pswiss/Swissler-2020-FireAnt3D-Design/CAD/Shell/Flower_Lainflat.SLDASM

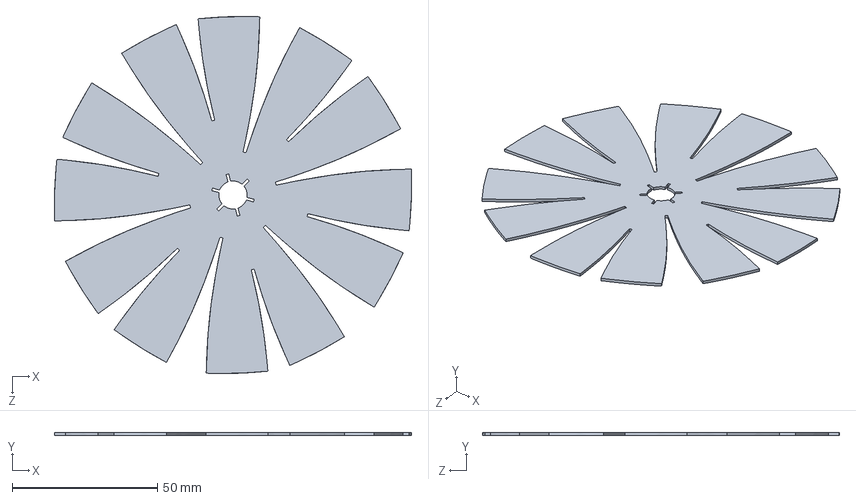
[picture p1: CAD file, 2020-07-23]
CAD/Shell/Flower_Lainflat.SLDASM
122.9 x 1.00 x 122.8 mm
