pswiss/Swissler-2020-FireAnt3D-Design/CAD/BatteryHalf_Assy.SLDASM

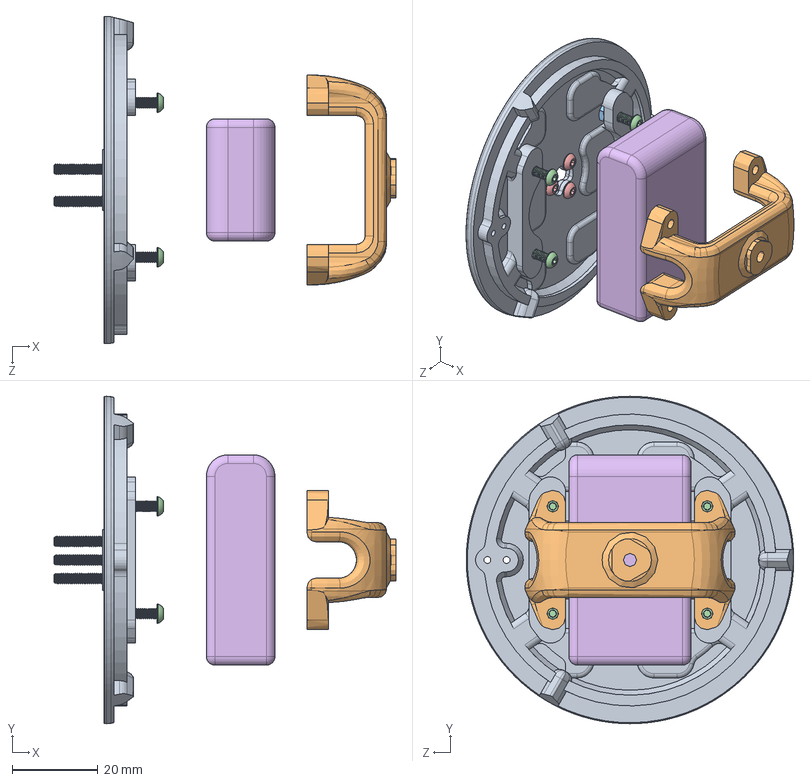
[picture p2: CAD file, 2020-07-23]
CAD/BatteryHalf_Assy.SLDASM
79.7 x 76.3 x 76.3 mm
BatteryHalf
Battery_Dock_Mount
90710A025_TYPE 18-8 SS THIN HEX NUT - DIN 439B x 4
92095A460_18-8 SS BUTTON-HEAD SOCKET CAP SCREW x 4
91239A760_CLASS 10.9 STL BUTTON-HEAD SOCKET CAP SCREW x 3
Turnigy nano-tech 450mAh 3S 65C Lipo (E-flite Compatible Blade 180CFX EFLB4503SJ30)
