pswiss/Swissler-2020-FireAnt3D-Design/CAD/Gear_Subassy.SLDASM

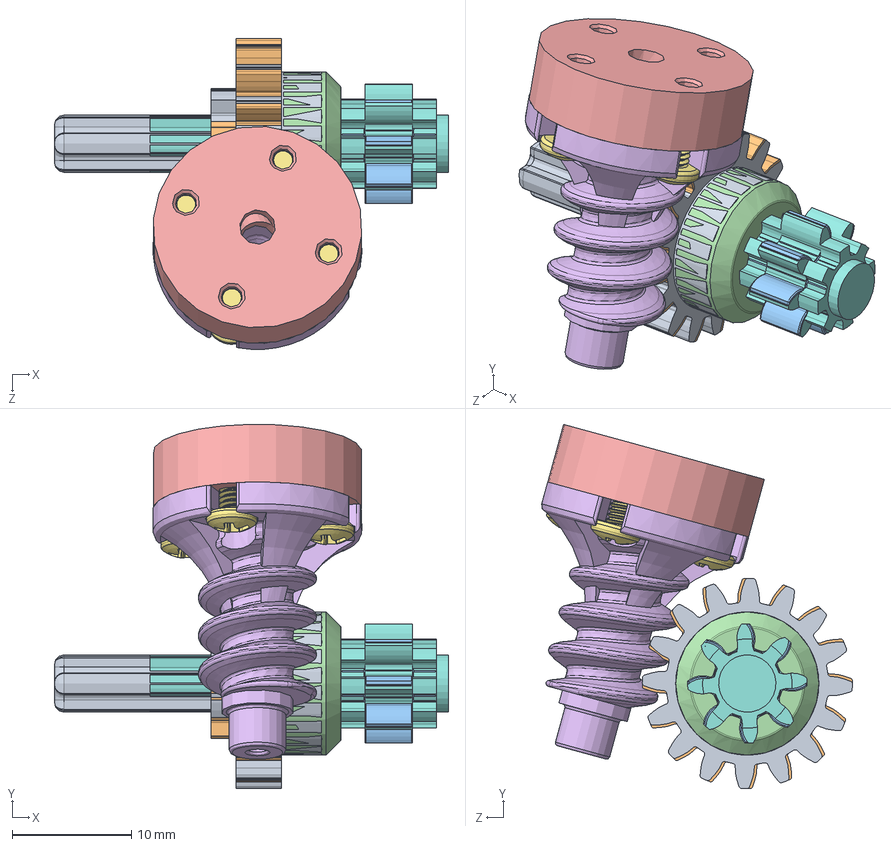
[picture p3: CAD file, 2020-07-23]
CAD/Gear_Subassy.SLDASM
33.0 x 30.5 x 26.0 mm
motorCoupling_2-56
WormGear_3
91735A010_TYPE 316 SS PAN HEAD PHILLIPS MACHINE SCREW x 4
New_8_tooth
ArmDrive_16_Replace
