pswiss/Swissler-2020-FireAnt3D-Design/CAD/Ground_Hoop_SubAssy.SLDASM

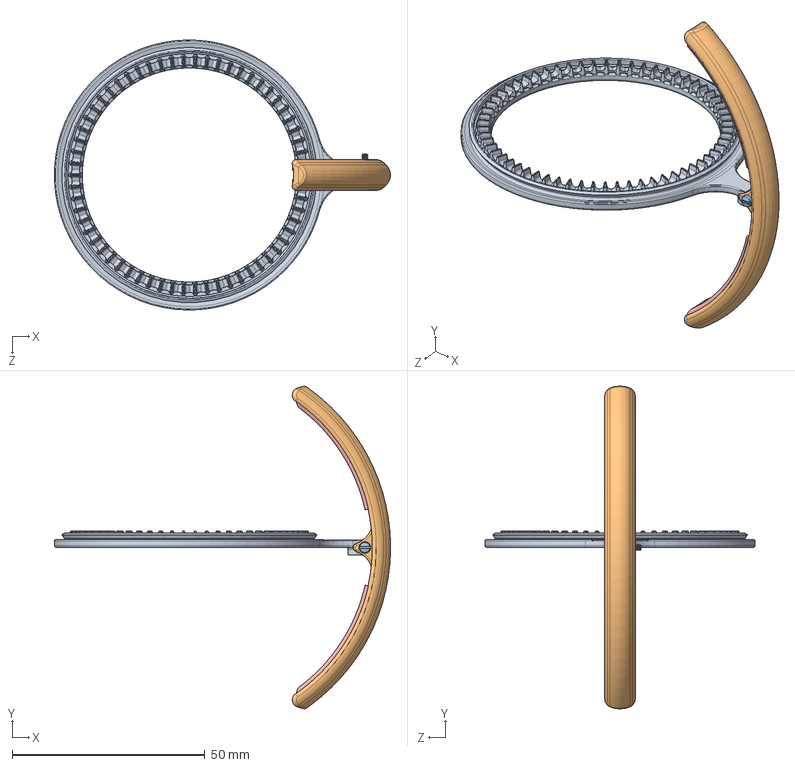
[picture p4: CAD file, 2020-07-23]
CAD/Ground_Hoop_SubAssy.SLDASM
87.1 x 83.6 x 70.0 mm
GroundHoop-2
Hoop_Formed
91800A008_METRIC CHEESE HEAD SLOTTED MACHINE SCREW
90591A109_ZINC PLATED STEEL HEX NUT
NonconductiveSlide x 2
