pswiss/Swissler-2020-FireAnt3D-Design/CAD/CoupledLegoWormGear.SLDASM

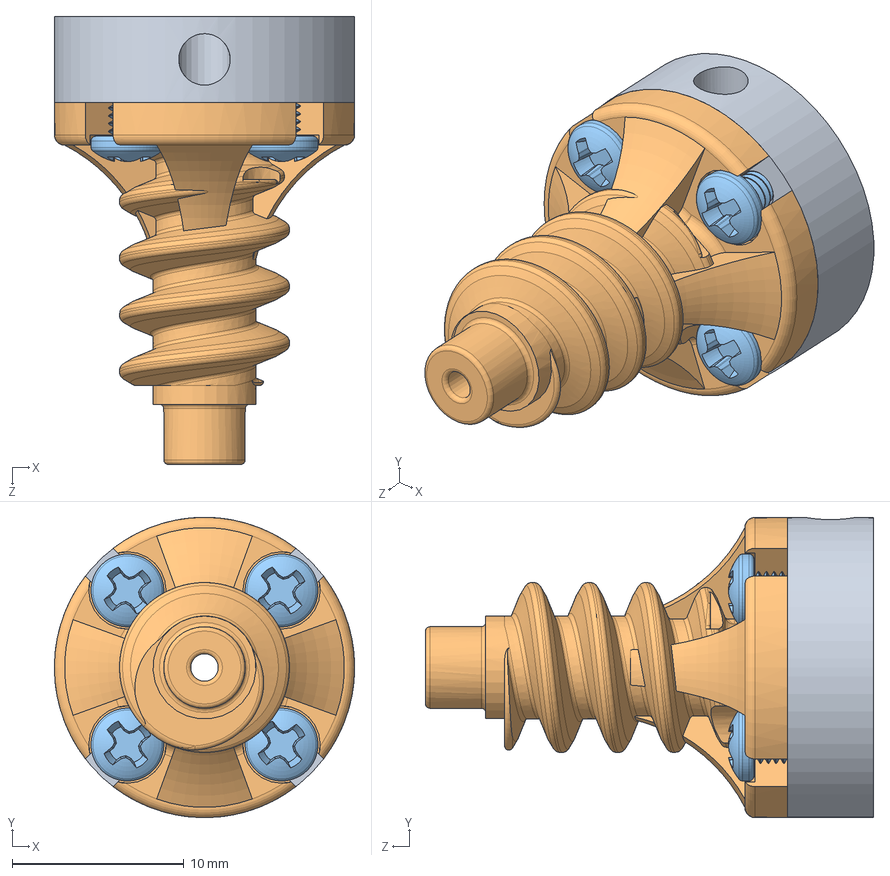
[picture p5: CAD file, 2020-07-23]
CAD/CoupledLegoWormGear.SLDASM
17.5 x 17.5 x 26.1 mm
motorCoupling_2-56
WormGear_3
91735A010_TYPE 316 SS PAN HEAD PHILLIPS MACHINE SCREW x 4
