pswiss/Swissler-2020-FireAnt3D-Design/CAD/HoopGear_SubAssy.SLDASM

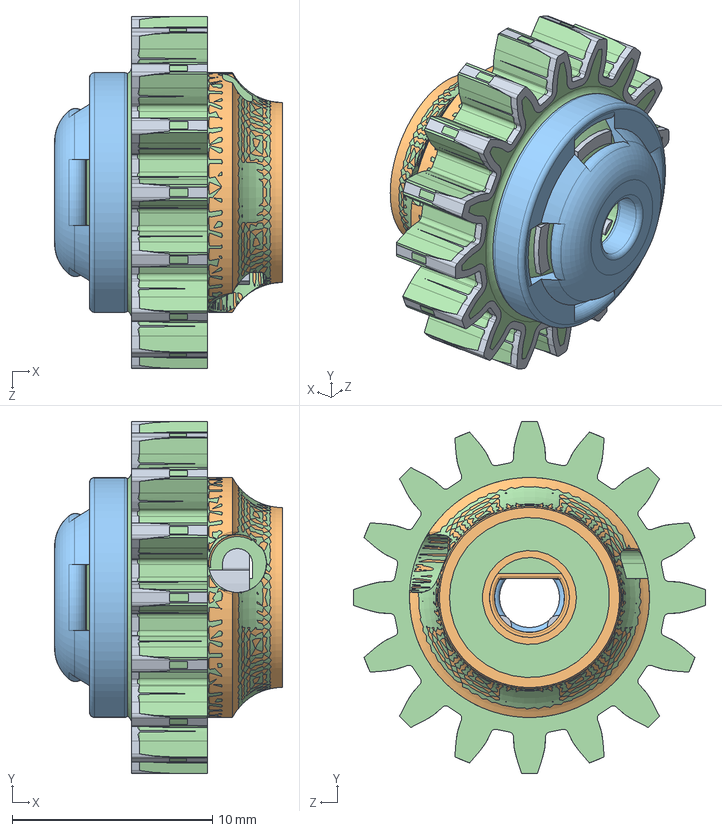
[picture p6: CAD file, 2020-07-23]
CAD/HoopGear_SubAssy.SLDASM
11.4 x 17.6 x 17.6 mm
new16Tooth
HoopGear_MotHalf
customHoopGear
