pswiss/Swissler-2020-FireAnt3D-Design/CAD/Arm_SubAssy.SLDASM

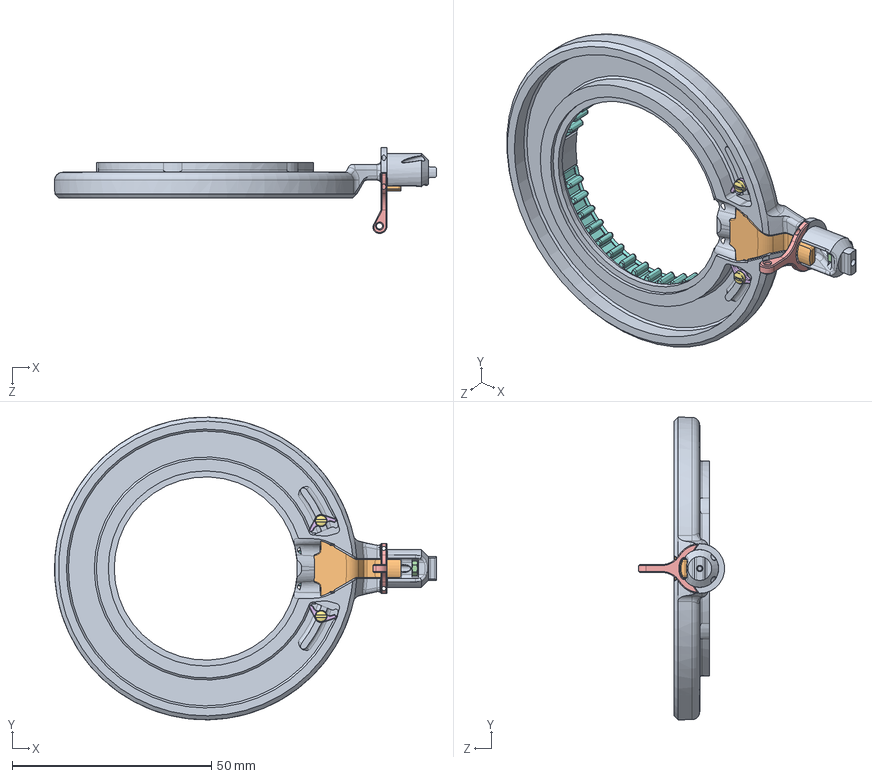
[picture p7: CAD file, 2020-07-23]
CAD/Arm_SubAssy.SLDASM
95.9 x 76.0 x 21.6 mm
SwingArm_Robot_arm_Strengthened
Arm_Top_Cover
91800A008_METRIC CHEESE HEAD SLOTTED MACHINE SCREW x 2
90591A109_ZINC PLATED STEEL HEX NUT
SwingArm_Robot_Returnhold
arm_limit_contact x 2
91800A004_METRIC CHEESE HEAD SLOTTED MACHINE SCREW x 2
SwingArm_Robot_gears
