pswiss/Swissler-2020-FireAnt3D-Design/CAD/ArmDrive_16_Replace.SLDPRT

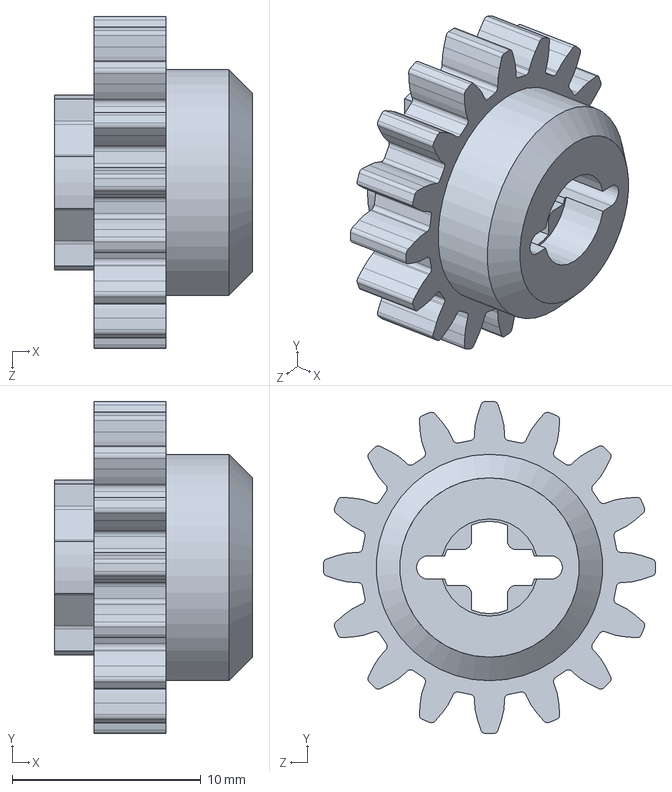
[picture p8: CAD file, 2020-07-23]
CAD/ArmDrive_16_Replace.SLDPRT
10.5 x 17.6 x 17.6 mm
