pswiss/Swissler-2020-FireAnt3D-Design/CAD/Shell/Flower_Lainflat_1.4mm.STL

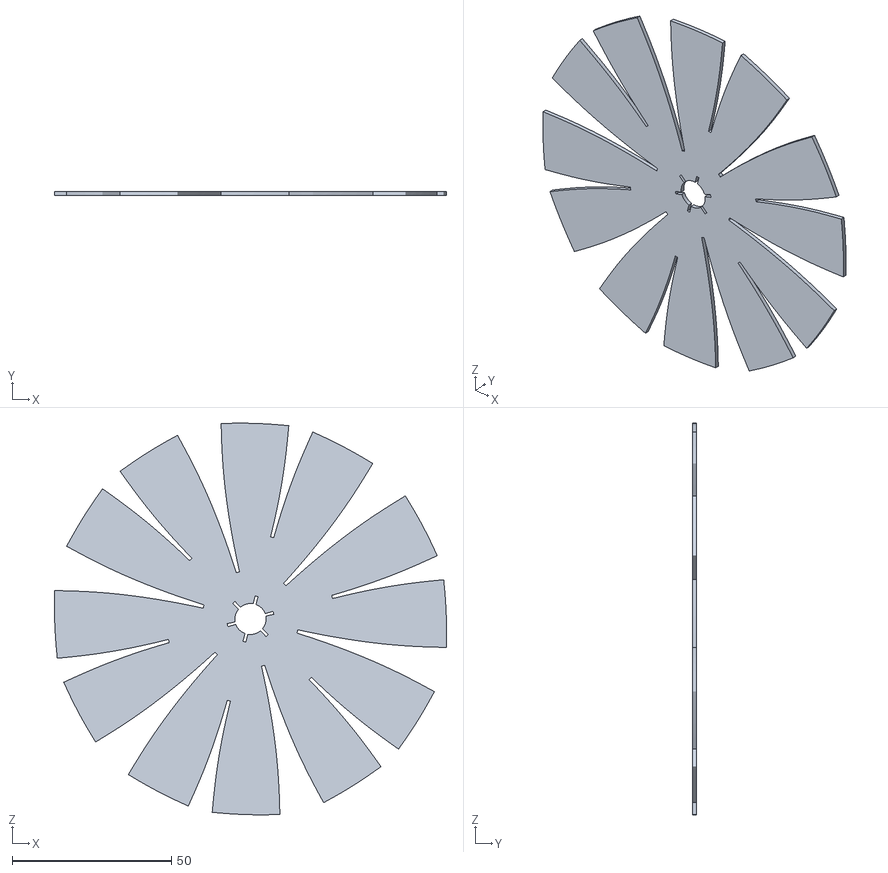
[picture p9: CAD file, 2020-07-23]
CAD/Shell/Flower_Lainflat_1.4mm.STL
122.9 x 1.40 x 122.8
