pswiss/Swissler-2020-FireAnt3D-Design/CAD/ForceSensorShield.SLDPRT

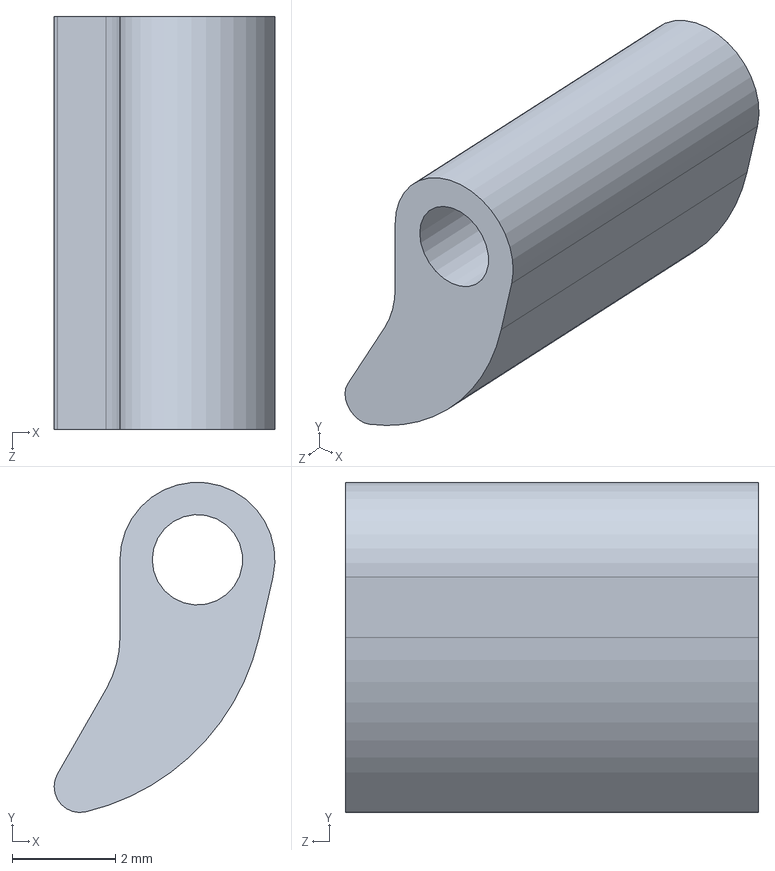
[picture p10: CAD file, 2020-07-23]
CAD/ForceSensorShield.SLDPRT
4.27 x 6.39 x 8.00 mm
