pswiss/Swissler-2020-FireAnt3D-Design/CAD/Arm_Attach.SLDPRT

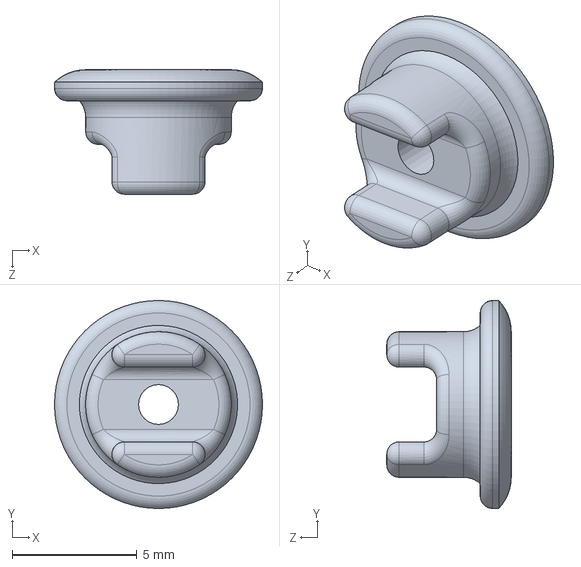
[picture p11: CAD file, 2020-07-23]
CAD/Arm_Attach.SLDPRT
8.35 x 8.35 x 5.00 mm
