pswiss/Swissler-2020-FireAnt3D-Design/CAD/Shell/Flower_Lainflat_0.2mm.STL

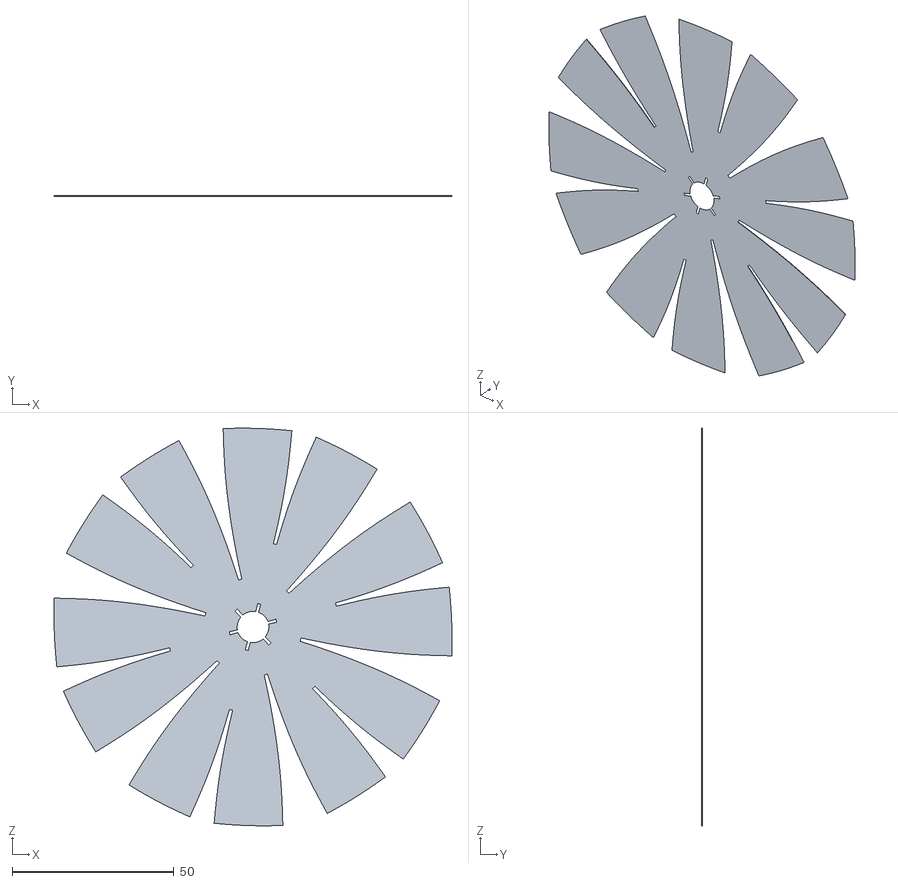
[picture p12: CAD file, 2020-07-23]
CAD/Shell/Flower_Lainflat_0.2mm.STL
122.9 x 0.2 x 122.8
