pswiss/Swissler-2020-FireAnt3D-Design/CAD/NonconductiveSlide.SLDPRT

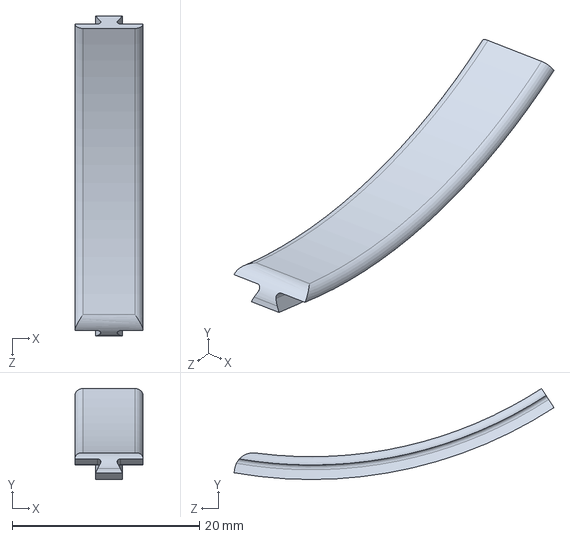
[picture p13: CAD file, 2020-07-23]
CAD/NonconductiveSlide.SLDPRT
7.28 x 9.72 x 34.2 mm
