pswiss/Swissler-2020-FireAnt3D-Design/CAD/Shell/Shell_Flower.SLDPRT

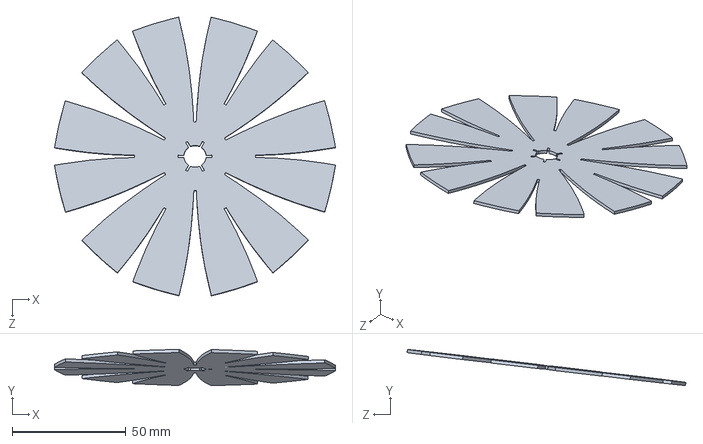
[picture p14: CAD file, 2020-07-23]
CAD/Shell/Shell_Flower.SLDPRT
123.4 x 15.9 x 122.5 mm
