pswiss/Swissler-2020-FireAnt3D-Design/CAD/Wings.SLDPRT

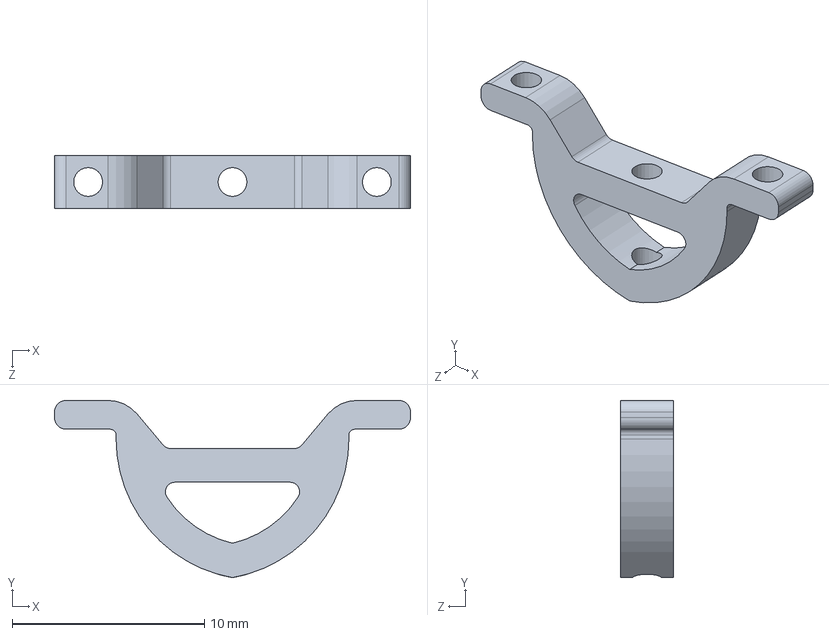
[picture p15: CAD file, 2020-07-23]
CAD/Wings.SLDPRT
18.5 x 9.21 x 2.75 mm
