pswiss/Swissler-2020-FireAnt3D-Design/CAD/HoopGear_HoldHalf.SLDPRT

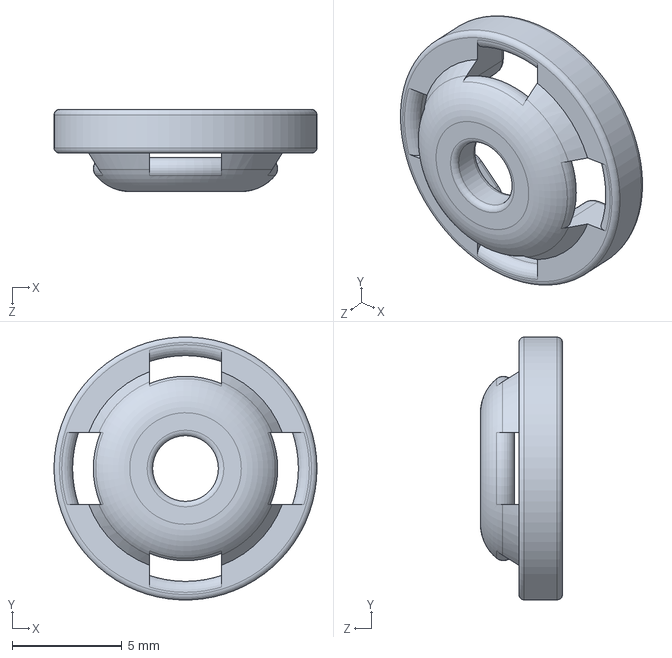
[picture p16: CAD file, 2020-07-23]
CAD/HoopGear_HoldHalf.SLDPRT
12.0 x 12.0 x 3.75 mm
