pswiss/Swissler-2020-FireAnt3D-Design/CAD/SwingArm_Robot_arm_Strengthened.SLDPRT

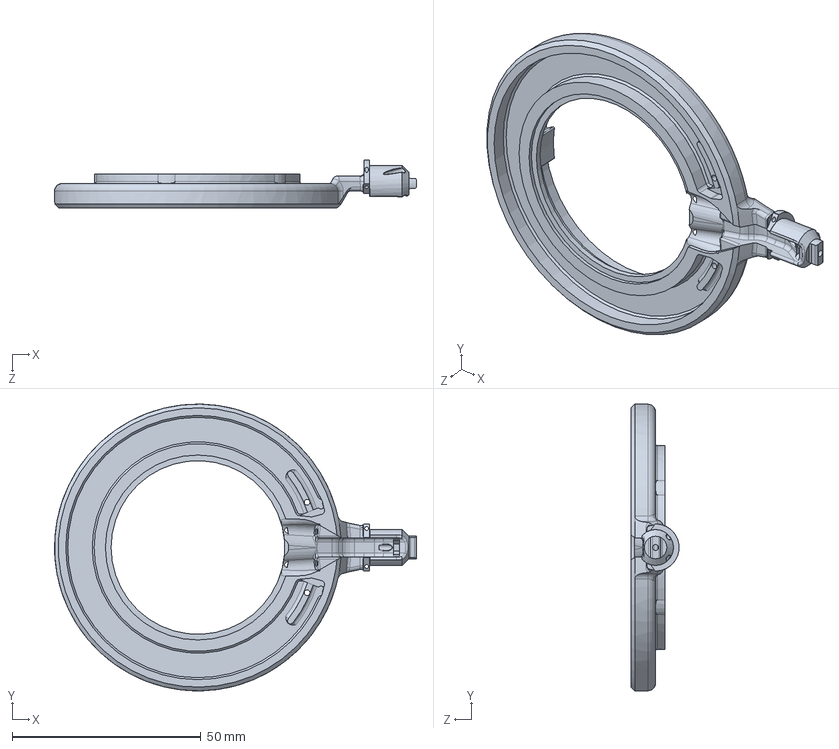
[picture p17: CAD file, 2020-07-23]
CAD/SwingArm_Robot_arm_Strengthened.SLDPRT
95.9 x 76.0 x 12.7 mm
