pswiss/Swissler-2020-FireAnt3D-Design/CAD/Hoop_Spring_Contact.SLDPRT

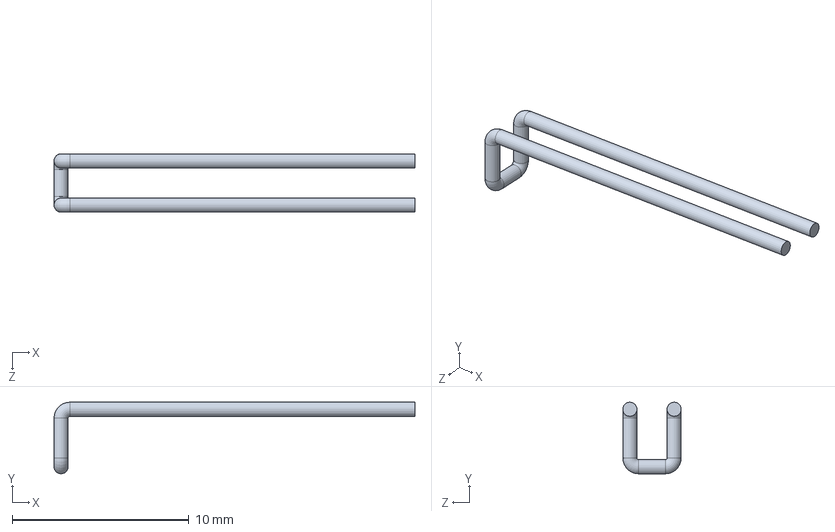
[picture p18: CAD file, 2020-07-23]
CAD/Hoop_Spring_Contact.SLDPRT
20.4 x 4.05 x 3.30 mm
