pswiss/Swissler-2020-FireAnt3D-Design/CAD/New_8_tooth.SLDPRT

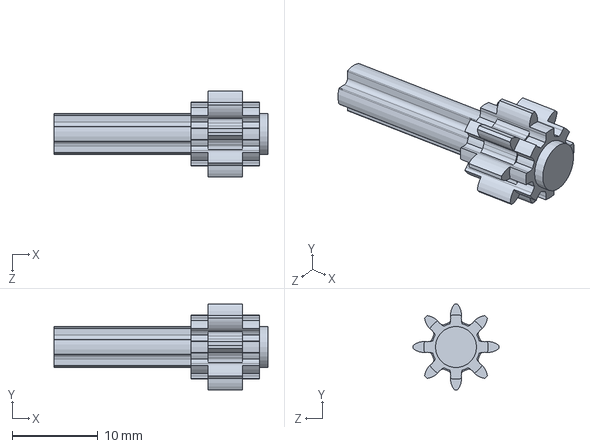
[picture p19: CAD file, 2020-07-23]
CAD/New_8_tooth.SLDPRT
25.0 x 9.99 x 9.99 mm
