pswiss/Swissler-2020-FireAnt3D-Design/CAD/arm_limit_contact.SLDPRT

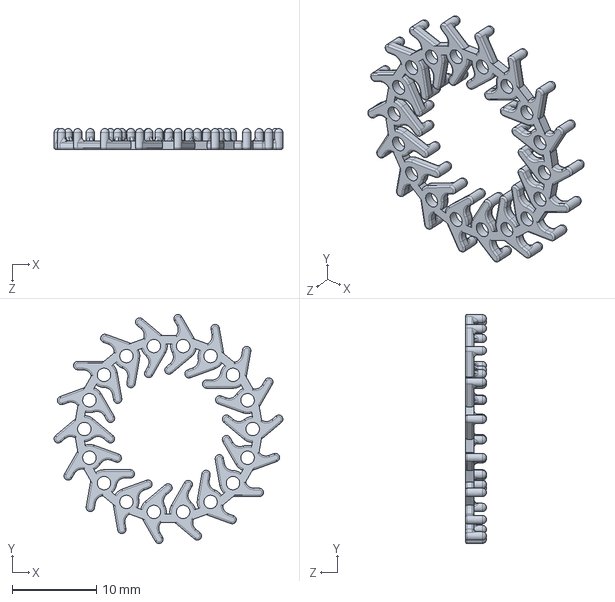
[picture p20: CAD file, 2020-07-23]
CAD/arm_limit_contact.SLDPRT
27.2 x 27.2 x 2.50 mm
