pswiss/Swissler-2020-FireAnt3D-Design/CAD/Gear_Spacer.SLDPRT

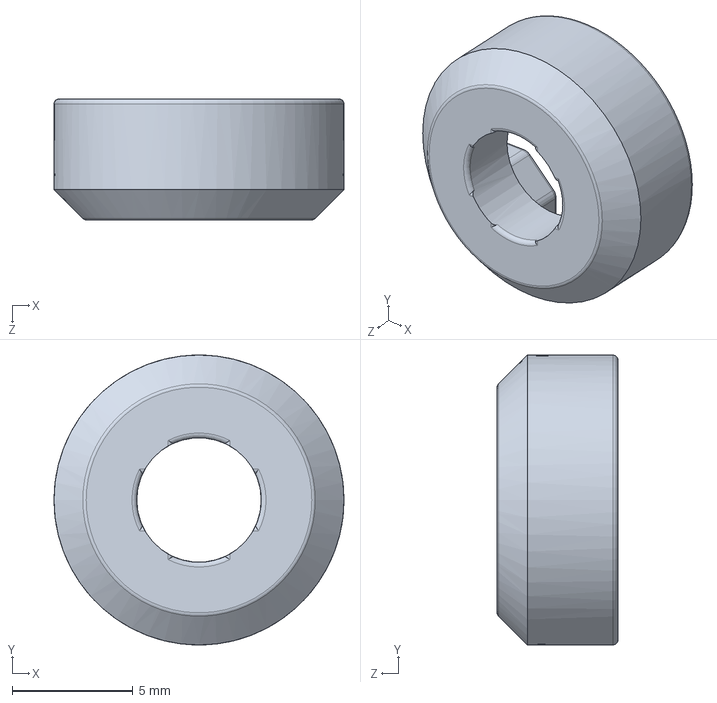
[picture p21: CAD file, 2020-07-23]
CAD/Gear_Spacer.SLDPRT
12.0 x 12.0 x 5.00 mm
