pswiss/Swissler-2020-FireAnt3D-Design/CAD/GroundHoop-2.SLDPRT

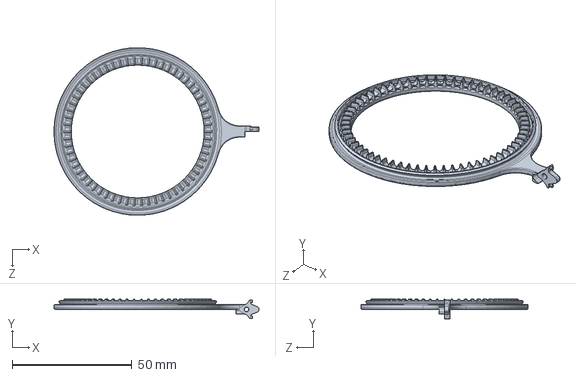
[picture p22: CAD file, 2020-07-23]
CAD/GroundHoop-2.SLDPRT
85.7 x 8.19 x 70.0 mm
