pswiss/Swissler-2020-FireAnt3D-Design/CAD/InnerShield.SLDPRT

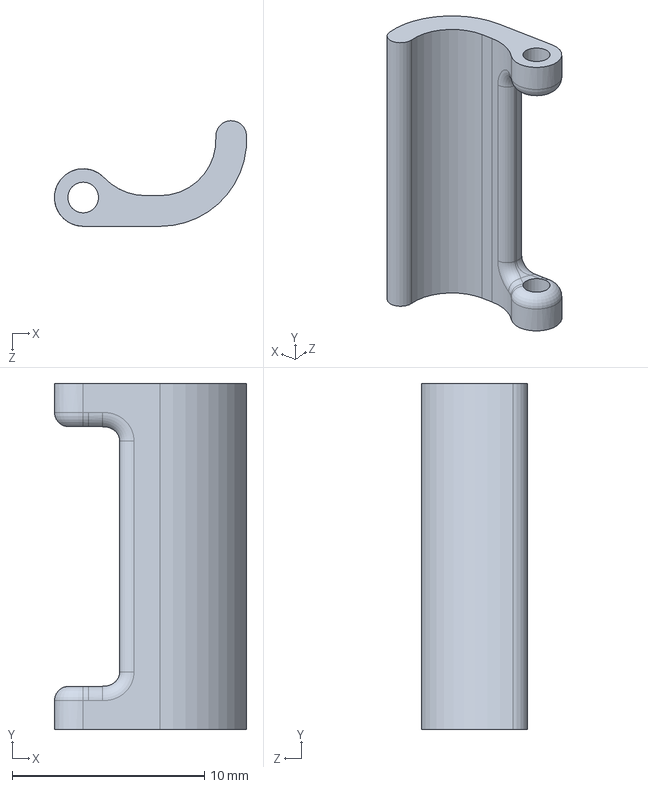
[picture p23: CAD file, 2020-07-23]
CAD/InnerShield.SLDPRT
10.00 x 18.0 x 5.50 mm
