pswiss/Swissler-2020-FireAnt3D-Design/CAD/Clocking_BatteryHalf.SLDPRT

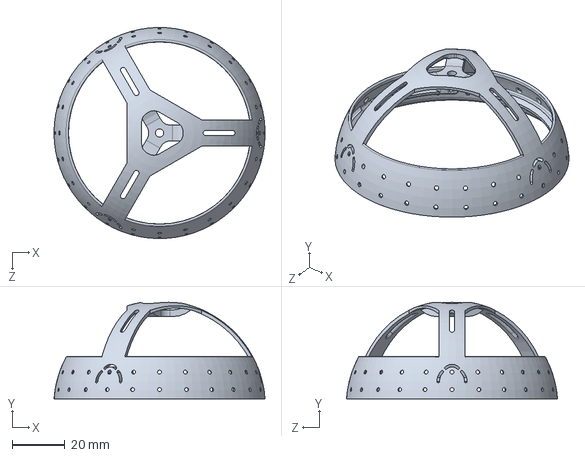
[picture p24: CAD file, 2020-07-23]
CAD/Clocking_BatteryHalf.SLDPRT
79.7 x 36.5 x 79.8 mm
