pswiss/Swissler-2020-FireAnt3D-Design/CAD/SwingArm_Robot_gears.SLDPRT

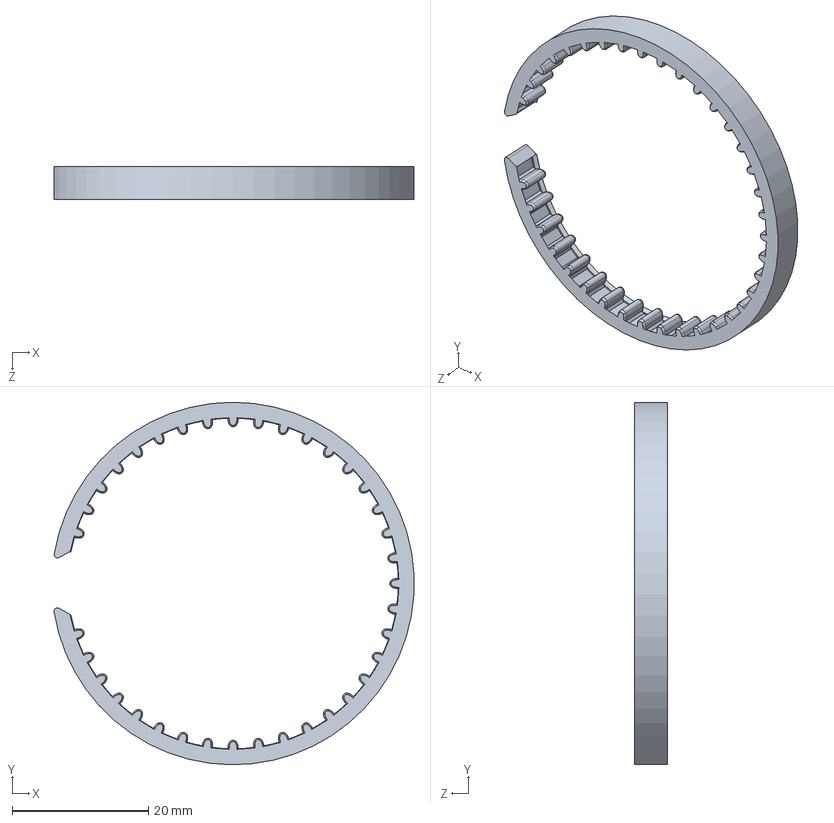
[picture p25: CAD file, 2020-07-23]
CAD/SwingArm_Robot_gears.SLDPRT
52.8 x 53.2 x 4.90 mm
