pswiss/Swissler-2020-FireAnt3D-Design/CAD/Hoop_Formed.SLDPRT

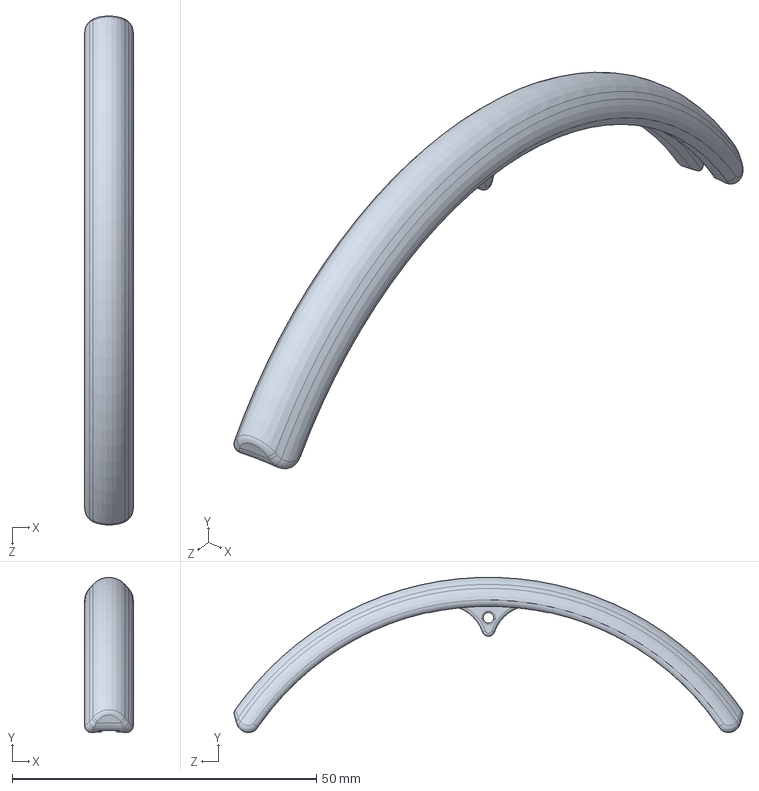
[picture p26: CAD file, 2020-07-23]
CAD/Hoop_Formed.SLDPRT
8.01 x 25.5 x 83.6 mm
