pswiss/Swissler-2020-FireAnt3D-Design/CAD/CenterBody_OuterPart.SLDPRT

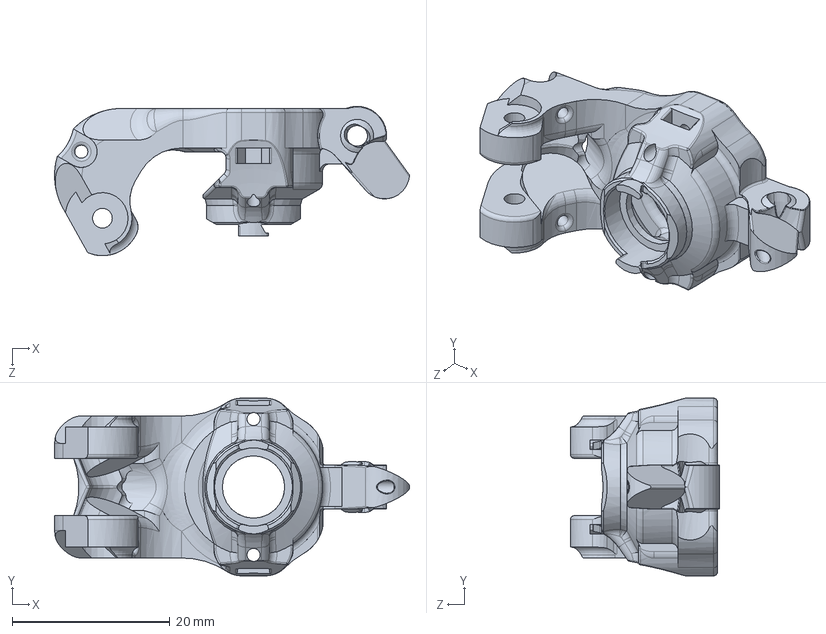
[picture p27: CAD file, 2020-07-23]
CAD/CenterBody_OuterPart.SLDPRT
45.0 x 22.5 x 18.9 mm
