pswiss/Swissler-2020-FireAnt3D-Design/CAD/Battery_Dock_Mount.SLDPRT

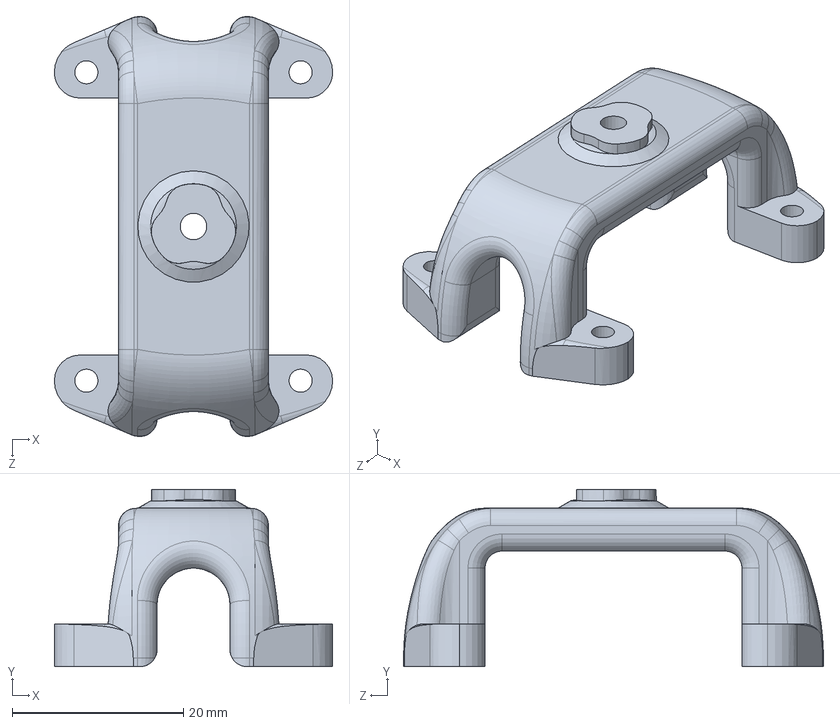
[picture p28: CAD file, 2020-07-23]
CAD/Battery_Dock_Mount.SLDPRT
32.5 x 20.7 x 49.0 mm
