pswiss/Swissler-2020-FireAnt3D-Design/CAD/customHoopGear.SLDPRT

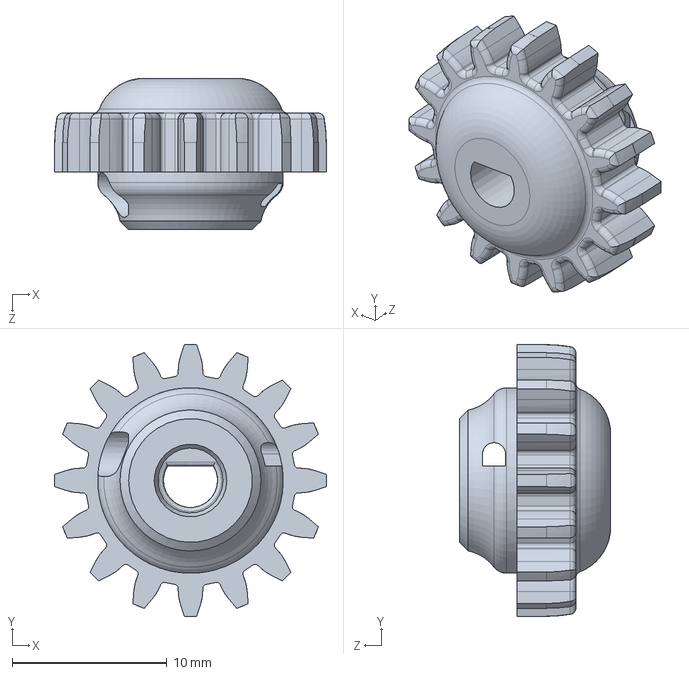
[picture p29: CAD file, 2020-07-23]
CAD/customHoopGear.SLDPRT
17.6 x 17.6 x 9.80 mm
