pswiss/Swissler-2020-FireAnt3D-Design/CAD/NonconductiveSlide_Flex.SLDPRT

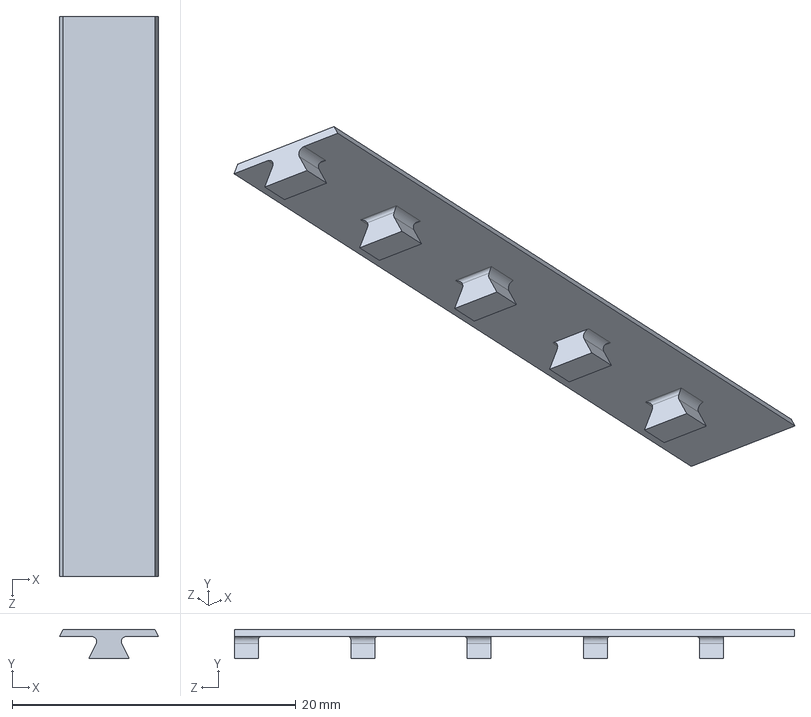
[picture p30: CAD file, 2020-07-23]
CAD/NonconductiveSlide_Flex.SLDPRT
7.00 x 2.05 x 39.5 mm
