pswiss/Swissler-2020-FireAnt3D-Design/CAD/WormGear_3.SLDPRT

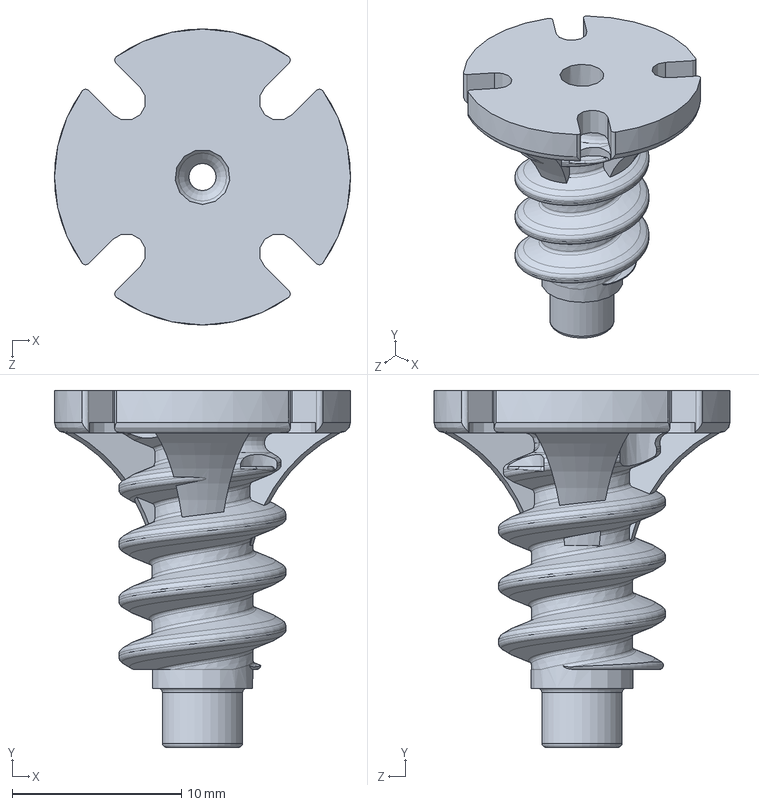
[picture p31: CAD file, 2020-07-23]
CAD/WormGear_3.SLDPRT
17.5 x 21.1 x 17.5 mm
