pswiss/Swissler-2020-FireAnt3D-Design/CAD/Turnigy nano-tech 450mAh 3S 65C Lipo (E-flite Compatible Blade 180CFX EFLB4503SJ30).SLDPRT

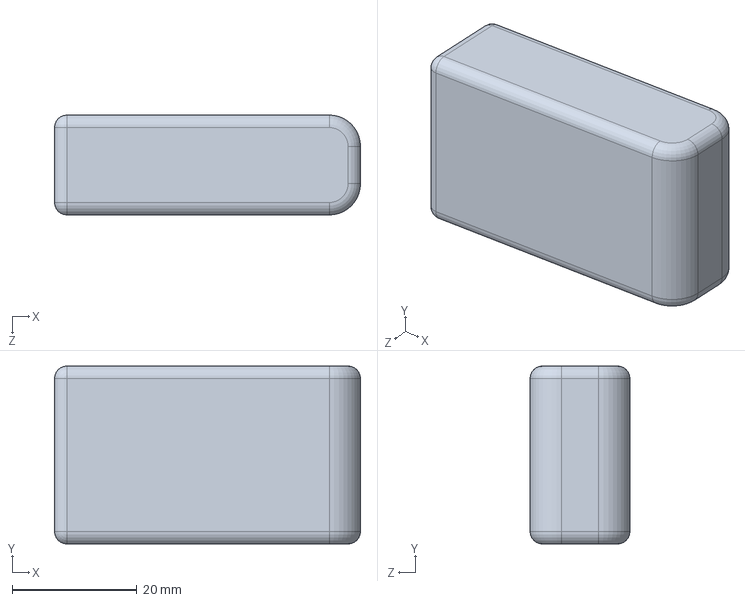
[picture p32: CAD file, 2020-07-23]
CAD/Turnigy nano-tech 450mAh 3S 65C Lipo (E-flite Compatible Blade 180CFX EFLB4503SJ30).SLDPRT
49.0 x 28.5 x 16.0 mm
