pswiss/Swissler-2020-FireAnt3D-Design/CAD/Clocking_MotorHalf.SLDPRT

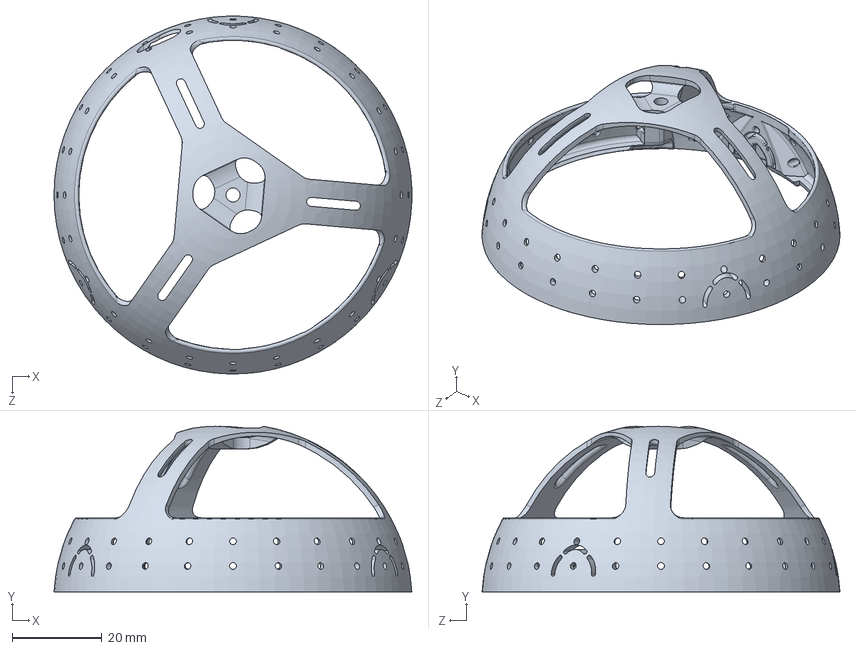
[picture p33: CAD file, 2020-07-23]
CAD/Clocking_MotorHalf.SLDPRT
79.8 x 36.9 x 79.8 mm
