pswiss/Swissler-2020-FireAnt3D-Design/CAD/HoopGear_MotHalf.SLDPRT

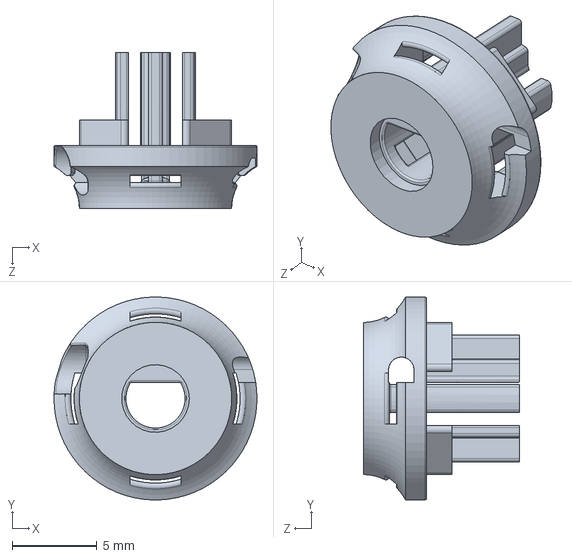
[picture p34: CAD file, 2020-07-23]
CAD/HoopGear_MotHalf.SLDPRT
12.0 x 12.0 x 9.25 mm
