pswiss/Swissler-2020-FireAnt3D-Design/CAD/Arm_Attach_2.SLDPRT

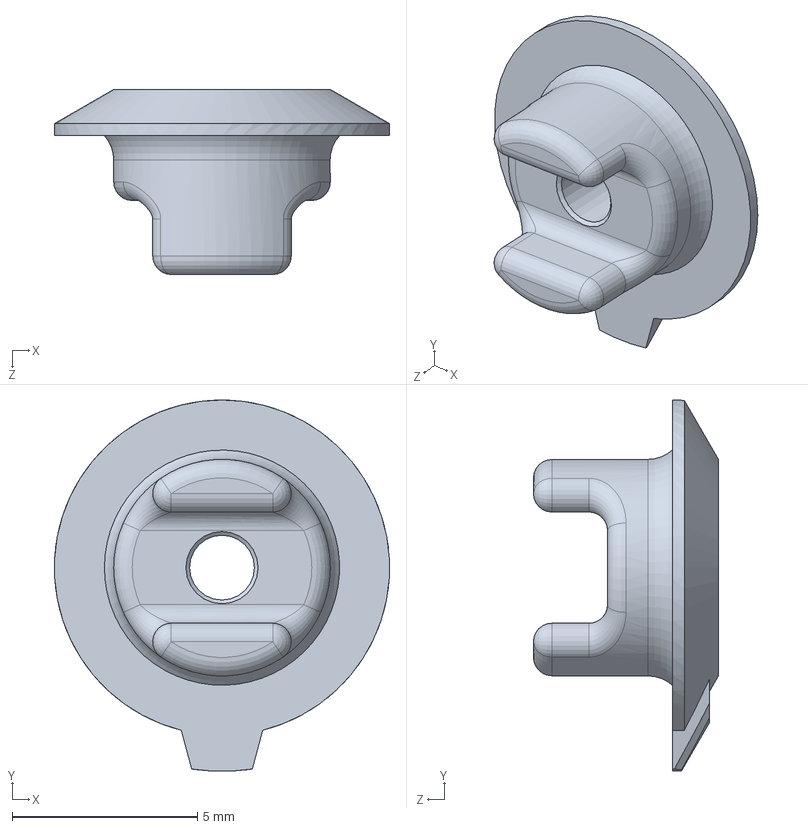
[picture p35: CAD file, 2020-07-23]
CAD/Arm_Attach_2.SLDPRT
9.05 x 10.0 x 5.00 mm
