pswiss/Swissler-2020-FireAnt3D-Design/CAD/Arm_Top_Cover.SLDPRT

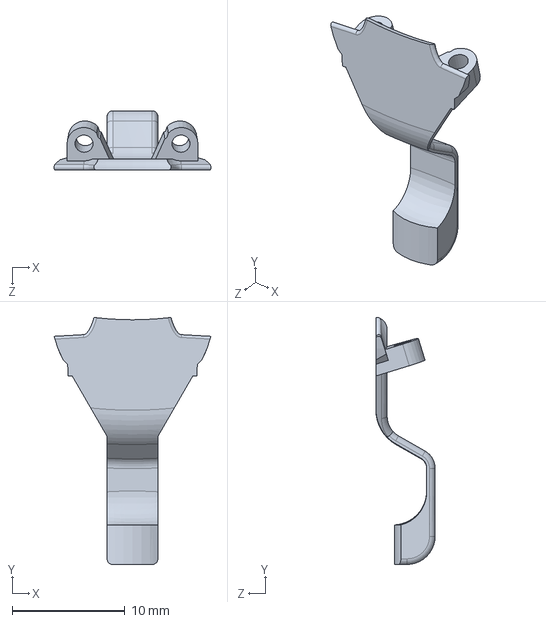
[picture p36: CAD file, 2020-07-23]
CAD/Arm_Top_Cover.SLDPRT
13.9 x 21.9 x 5.25 mm
