pswiss/Swissler-2020-FireAnt3D-Design/CAD/MotorHalf.SLDPRT

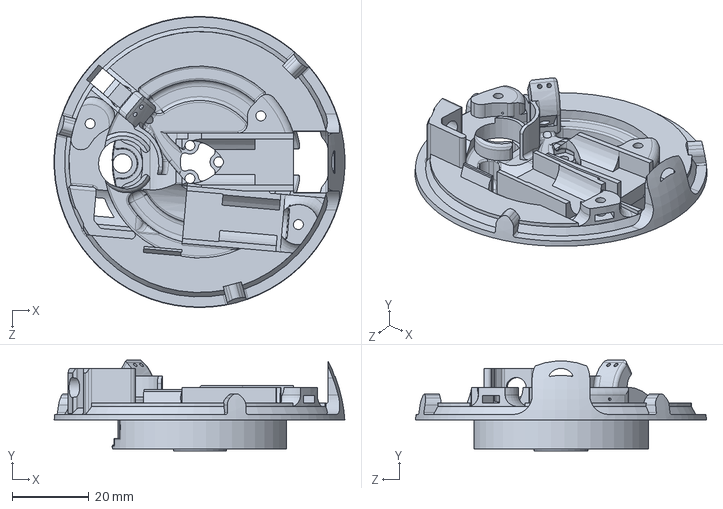
[picture p37: CAD file, 2020-07-23]
CAD/MotorHalf.SLDPRT
75.8 x 23.6 x 75.8 mm
