pswiss/Swissler-2020-FireAnt3D-Design/CAD/BatteryHalf.SLDPRT

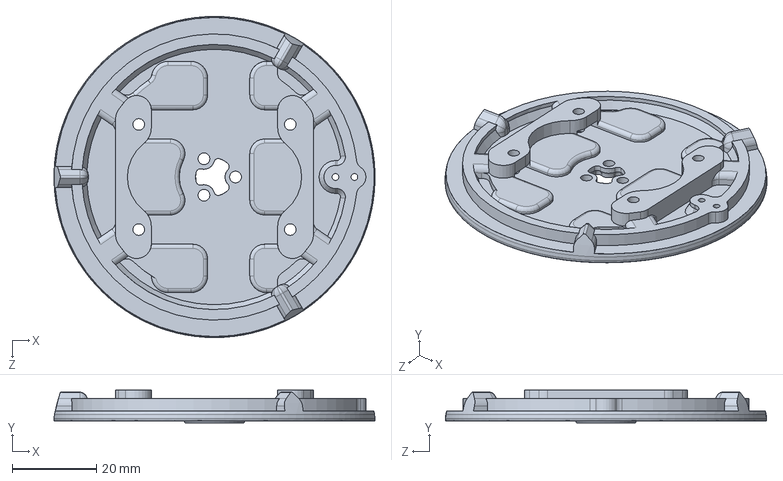
[picture p38: CAD file, 2020-07-23]
CAD/BatteryHalf.SLDPRT
76.3 x 7.75 x 76.3 mm
