pswiss/Swissler-2020-FireAnt3D-Design/(list of files, cad)

Other CAD files:
CAD/Arm_Retain.SLDPRT
