pswiss/Swissler-2020-FireAnt3D-Design/CAD/Shell/Flower_Lainflat.PDF

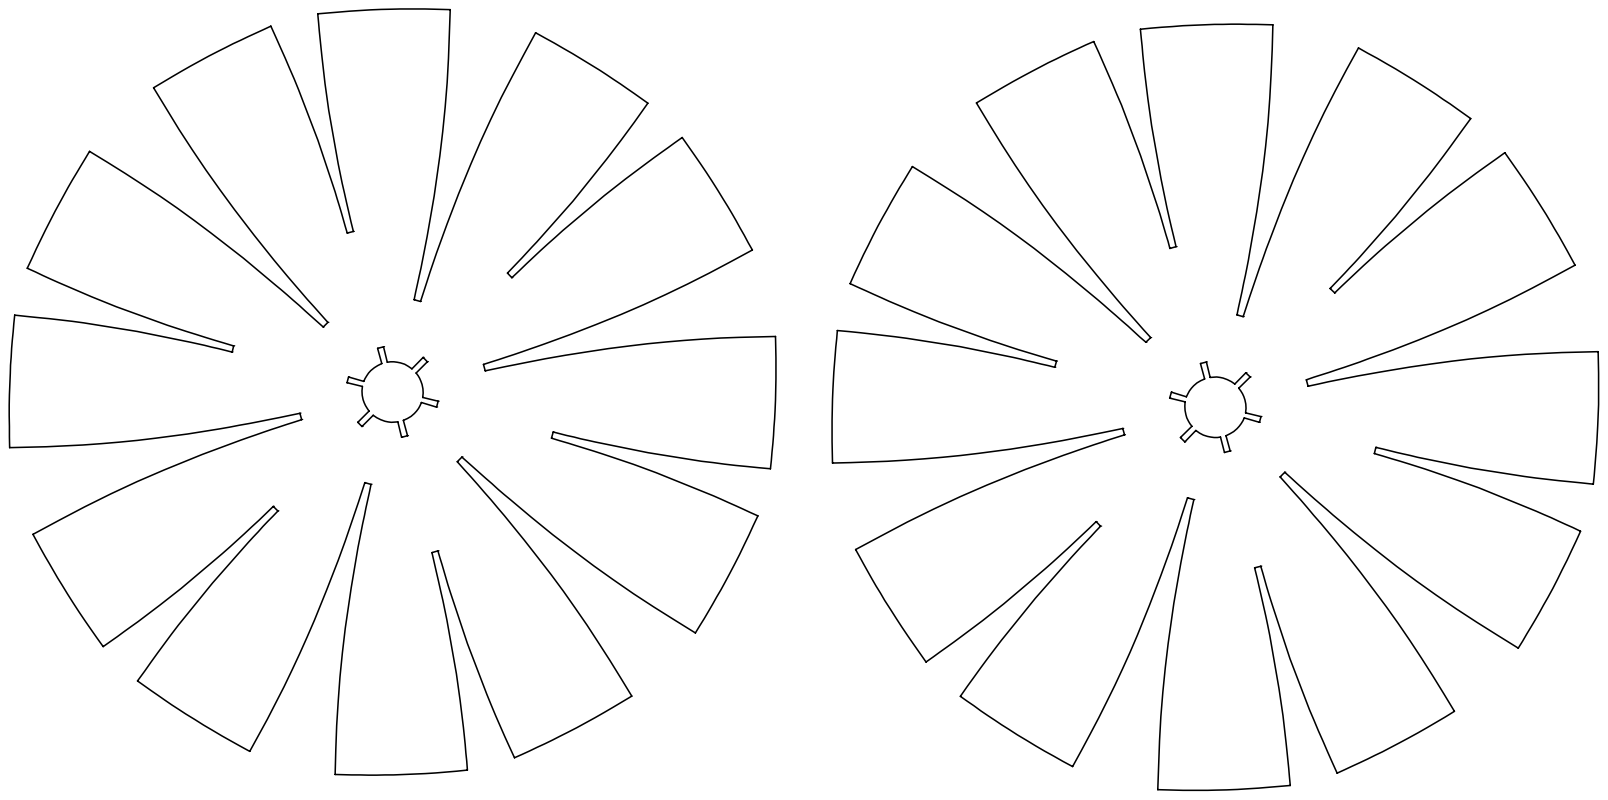
[picture p39: page 1]
