pswiss/Swissler-2020-FireAnt3D-Design/Electronics/fa3d_Dock_NEW_Small.brd

## EAGLE design Electronics/fa3d_Dock_NEW_Small.brd (2020-07-23)

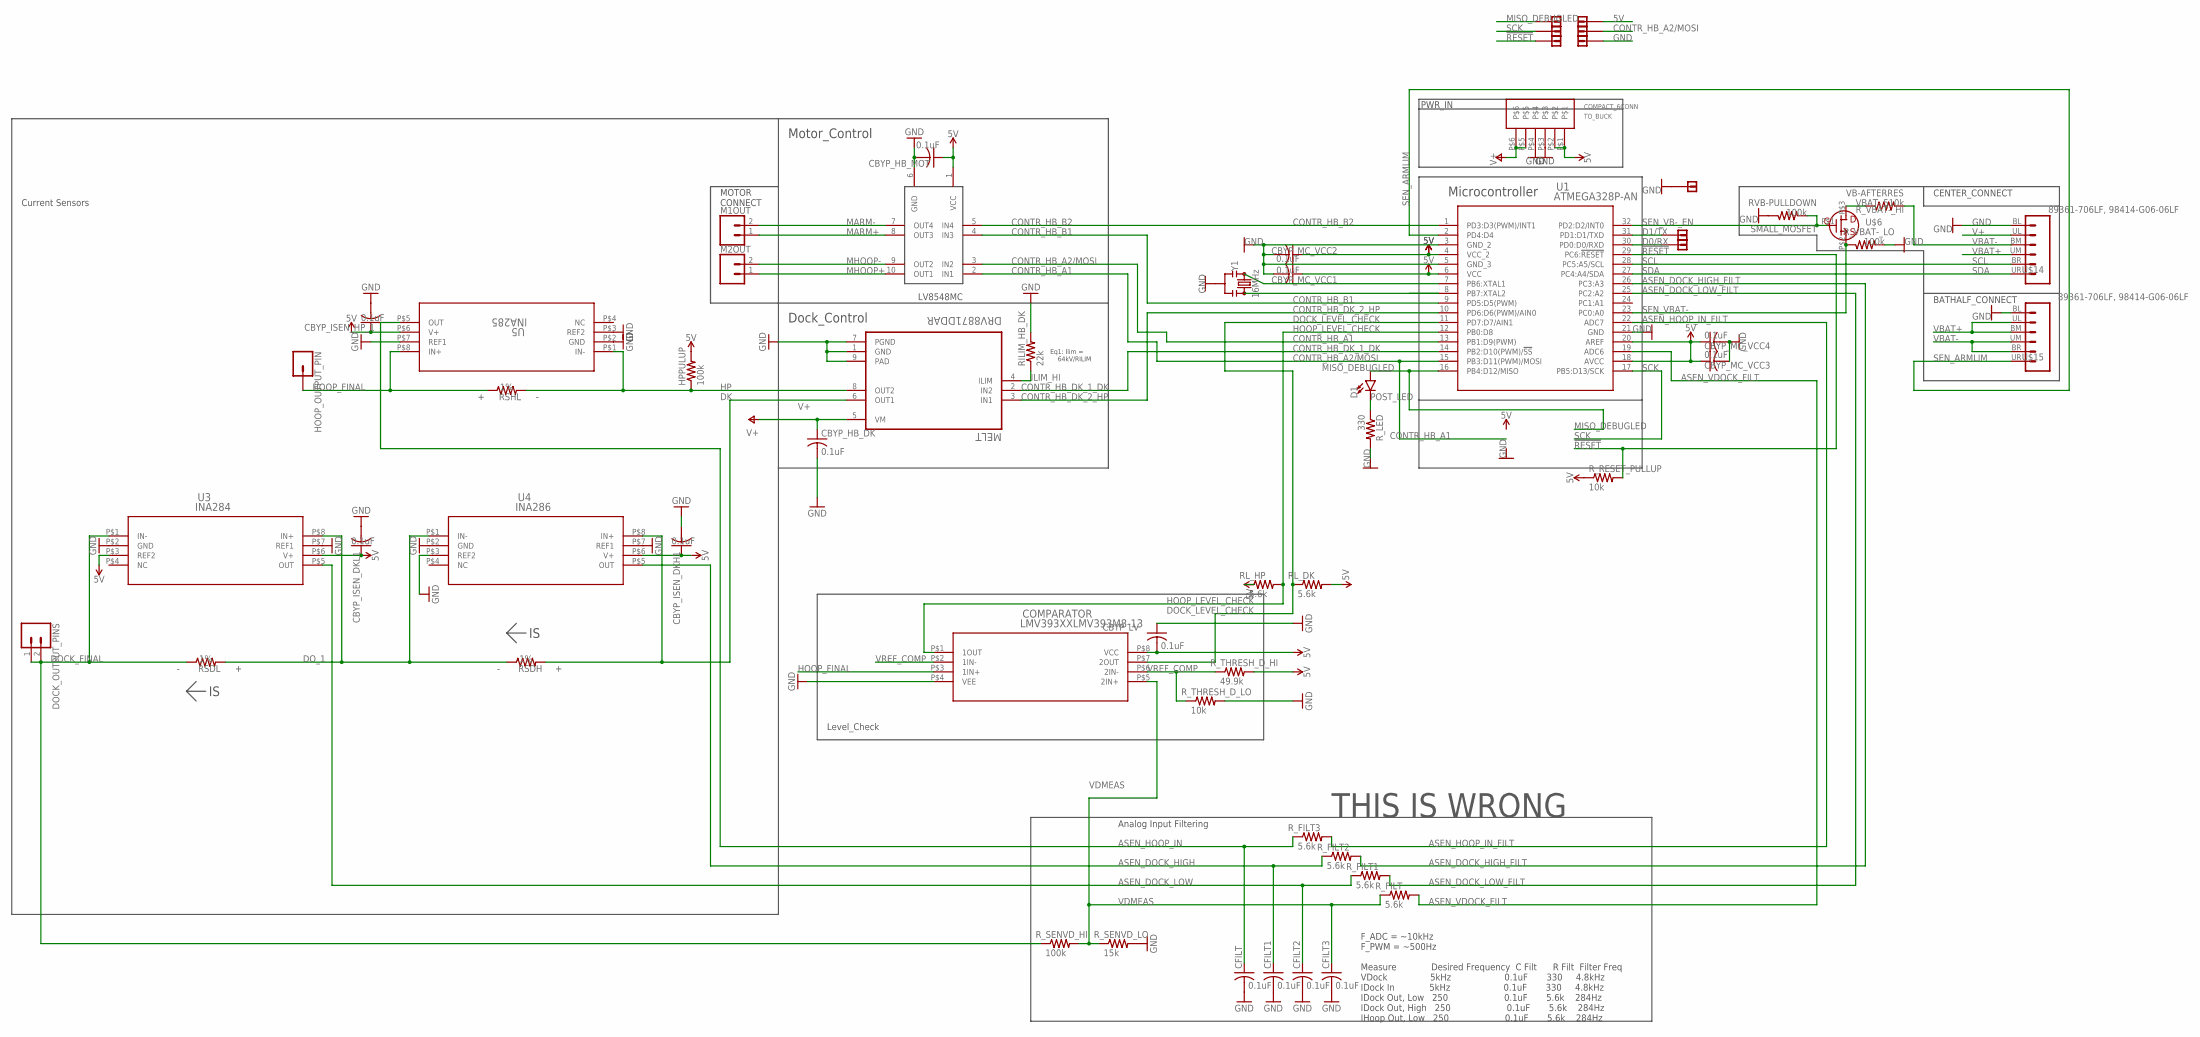
[picture p40: schematic fa3d_Dock_NEW_Small.sch]

Parts:
CBYP_HB_DK: 0.1uF; C0603; PARTNO CL10B104KB8NNNC
CBYP_HB_MOT: 0.1uF; C0402; PARTNO 885012105010
CBYP_ISEN_DKH1: 0.1uF; C0402; PARTNO 885012105010
CBYP_ISEN_DKL1: 0.1uF; C0402; PARTNO 885012105010
CBYP_ISEN_HP_1: 0.1uF; C0402; PARTNO 885012105010
CBYP_LV: 0.1uF; C0402; PARTNO 885012105010
CBYP_MC_VCC1, CBYP_MC_VCC2, CBYP_MC_VCC3, CBYP_MC_VCC4: 0.1uF; C0402; PARTNO 885012105010
CFILT, CFILT1, CFILT2, CFILT3: 0.1uF; C0402; PARTNO 885012105010
COMPARATOR: LMV393XXLMV393M8-13; MSOP-8; PARTNO LMV393M8-13
D1: LED0603; LED-0603; PARTNO SML-D12U1WT86
DOCK_OUTPUT_PINS: CONN_02; 1X02
HOOP_OUTPUT_PIN: CONN_01; 1X01
HPPULUP: 100k; R0402; PARTNO RMCF0402JT100K
M1OUT, M2OUT: CONN_02; 1X02
MELT: DRV8871DDAR; SOIC127P600X170-8N; PARTNO DRV8871DDAR
MOTOR: LV8548MC-AH; 10-SOP; PARTNO LV8548MC-AH
RILIM_HB_DK: 22k; R0603; PARTNO RMCF0402JT22K0
RL_DK: 5.6k; R0402; PARTNO CRGCQ0402F5K6
RL_HP: 5.6k; R0402; PARTNO CRGCQ0402F5K6
RSDH: 25m; R0603; PARTNO ERJ-3BWFR025V
RSDL: 25m; R0603; PARTNO ERJ-3BWFR025V
RSHL: 25m; R0603; PARTNO ERJ-3BWFR025V
RVB-PULLDOWN: 100k; R0402; PARTNO RMCF0402JT100K
R_FILT, R_FILT1, R_FILT2, R_FILT3: 5.6k; R0402; PARTNO CRGCQ0402F5K6
R_LED: 330; R0402; PARTNO RMCF0402JT330R
R_RESET_PULLUP: 10k; R0402; PARTNO RR0510P-103-D
R_SENVD_HI: 100k; R0402; PARTNO RMCF0402JT100K
R_SENVD_LO: 15k; R0402; PARTNO RMCF0402JT15K0
R_THRESH_D_HI: 49.9k; R0402; PARTNO RMCF0402FT49K9
R_THRESH_D_LO: 10k; R0402; PARTNO RR0510P-103-D
R_VBAT-_HI: 510k; R0402; PARTNO RMCF0402JT510K
R_VBAT-_LO: 100k; R0402; PARTNO RMCF0402JT100K
TO_BUCK: COMPACT_6CONN
U1: ATMEGA328P-AN; 32A; PARTNO ATMEGA328P-AUR
U3: INA284; 8-VSSOP; PARTNO INA284AIDGKR
U4: INA286; 8-VSSOP; PARTNO INA286AIDGKR
U5: INA285; 8-VSSOP; PARTNO INA285AIDGKR
U$1, U$2, U$3, U$4, U$5, U$7, U$8, U$9, U$10: SIMPLE_VIA_CONNECTION; SIMPLEVIA
U$6: SMALL_MOSFET; SOT-23; PARTNO BSS138
U$14, U$15: 89361-706LF, 98414-G06-06LF; 2X3_2MMPITCH; PARTNO 98414-G06-06LF
Y1: 16MHz; RESONATOR-SMD-3.2X1.3; PARTNO CSTNE16M0V530000R0

Connections:
5V: CBYP_HB_MOT.1, CBYP_ISEN_DKH1.1, CBYP_ISEN_DKL1.1, CBYP_ISEN_HP_1.1, CBYP_LV.2, CBYP_MC_VCC1.1, CBYP_MC_VCC2.1, CBYP_MC_VCC3.1, CBYP_MC_VCC4.1, COMPARATOR.P$8 (VCC), HPPULUP.2, MOTOR.1 (VCC), RL_DK.2, RL_HP.1, R_RESET_PULLUP.1, R_THRESH_D_HI.2, TO_BUCK.P$1, TO_BUCK.P$2, U1.4 (VCC_2), U1.6 (VCC), U1.18 (AVCC), U1.20 (AREF), U3.P$3 (REF2), U3.P$6 (V+), U4.P$6 (V+), U5.P$6 (V+), U$10.P$1
!RESET: R_RESET_PULLUP.2, U1.29 (PC6:!RESET), U$7.P$1
ASEN_DOCK_HIGH: CFILT1.1, R_FILT2.1, U4.P$5 (OUT)
ASEN_DOCK_HIGH_FILT: R_FILT2.2, U1.26 (PC3:A3)
ASEN_DOCK_LOW: CFILT2.1, R_FILT1.1, U3.P$5 (OUT)
ASEN_DOCK_LOW_FILT: R_FILT1.2, U1.25 (PC2:A2)
ASEN_HOOP_IN: CFILT.1, R_FILT3.1, U5.P$5 (OUT)
ASEN_HOOP_IN_FILT: R_FILT3.2, U1.22 (ADC7)
ASEN_VDOCK_FILT: R_FILT.2, U1.19 (ADC6)
CONTR_HB_A1: MOTOR.2 (IN1), U1.15 (PB3:D11(PWM)/MOSI)
CONTR_HB_A2/MOSI: MOTOR.3 (IN2), U1.13 (PB1:D9(PWM)), U$9.P$1
CONTR_HB_B1: MOTOR.4 (IN3), U1.9 (PD5:D5(PWM))
CONTR_HB_B2: MOTOR.5 (IN4), U1.1 (PD3:D3(PWM)/INT1)
CONTR_HB_DK_1_DK: MELT.2 (IN2), U1.14 (PB2:D10(PWM)/!SS)
CONTR_HB_DK_2_HP: MELT.3 (IN1), U1.10 (PD6:D6(PWM)/AIN0)
D0/RX: U1.30 (PD0:D0/RXD), U$5.P$1
D1/TX: U1.31 (PD1:D1/TXD), U$4.P$1
DK: MELT.6 (OUT1), RSDH.2, U4.P$8 (IN+)
DOCK_FINAL: DOCK_OUTPUT_PINS.1, DOCK_OUTPUT_PINS.2, RSDL.1, R_SENVD_HI.1, U3.P$1 (IN-)
DOCK_LEVEL_CHECK: COMPARATOR.P$7 (2OUT), RL_DK.1, U1.11 (PD7:D7/AIN1)
DO_1: RSDH.1, RSDL.2, U3.P$8 (IN+), U4.P$1 (IN-)
GND: CBYP_HB_DK.2, CBYP_HB_MOT.2, CBYP_ISEN_DKH1.2, CBYP_ISEN_DKL1.2, CBYP_ISEN_HP_1.2, CBYP_LV.1, CBYP_MC_VCC1.2, CBYP_MC_VCC2.2, CBYP_MC_VCC3.2, CBYP_MC_VCC4.2, CFILT.2, CFILT1.2, CFILT2.2, CFILT3.2, COMPARATOR.P$4 (VEE), MELT.1 (GND), MELT.7 (PGND), MELT.9 (PAD), MOTOR.6 (GND), RILIM_HB_DK.2, RVB-PULLDOWN.1, R_LED.2, R_SENVD_LO.2, R_THRESH_D_LO.2, R_VBAT-_LO.2, TO_BUCK.P$3, TO_BUCK.P$4, U1.3 (GND_2), U1.5 (GND_3), U1.21 (GND), U3.P$2 (GND), U3.P$7 (REF1), U4.P$2 (GND), U4.P$3 (REF2), U4.P$7 (REF1), U5.P$2 (GND), U5.P$3 (REF2), U5.P$7 (REF1), U$1.P$1, U$8.P$1, U$14.BL (1), U$15.BL (1), Y1.2
HOOP_FINAL: COMPARATOR.P$3 (1IN+), HOOP_OUTPUT_PIN.1, RSHL.1, U5.P$8 (IN+)
HOOP_LEVEL_CHECK: COMPARATOR.P$1 (1OUT), RL_HP.2, U1.12 (PB0:D8)
HP: HPPULUP.1, MELT.8 (OUT2), RSHL.2, U5.P$1 (IN-)
ILIM_HI: MELT.4 (ILIM), RILIM_HB_DK.1
MARM+: M1OUT.1, MOTOR.8 (OUT3)
MARM-: M1OUT.2, MOTOR.7 (OUT4)
MHOOP+: M2OUT.1, MOTOR.10 (OUT1)
MHOOP-: M2OUT.2, MOTOR.9 (OUT2)
MISO_DEBUGLED: D1.A, U1.16 (PB4:D12/MISO), U$2.P$1
POST_LED: D1.C, R_LED.1
SCK: U1.17 (PB5:D13/SCK), U$3.P$1
SCL: U1.28 (PC5:A5/SCL), U$14.BR (5)
SDA: U1.27 (PC4:A4/SDA), U$14.UR (6)
SEN_ARMLIM: U1.2 (PD4:D4), U$15.UR (6)
SEN_VB-_EN: RVB-PULLDOWN.2, U1.32 (PD2:D2/INT0), U$6.P$1 (G)
SEN_VBAT-: R_VBAT-_LO.1, U1.23 (PC0:A0), U$6.P$2 (S)
V+: CBYP_HB_DK.1, MELT.5 (VM), TO_BUCK.P$5, TO_BUCK.P$6, U$14.UL (2)
VB-AFTERRES: R_VBAT-_HI.1, U$6.P$3 (D)
VBAT+: U$14.UM (4), U$15.BM (3), U$15.UL (2)
VBAT-: R_VBAT-_HI.2, U$14.BM (3), U$15.BR (5), U$15.UM (4)
VDMEAS: CFILT3.1, COMPARATOR.P$5 (2IN+), R_FILT.1, R_SENVD_HI.2, R_SENVD_LO.1
VREF_COMP: COMPARATOR.P$2 (1IN-), COMPARATOR.P$6 (2IN-), R_THRESH_D_HI.1, R_THRESH_D_LO.1
XTAL1/TOSC1: U1.7 (PB6:XTAL1), Y1.1
XTAL2/TOSC2: U1.8 (PB7:XTAL2), Y1.3

Notes on the sheet:
Microcontroller
PWR_IN
CENTER_CONNECT
BATHALF_CONNECT
Motor_Control
Dock_Control
Eq1: Ilim = 64kV/RILIM
MOTOR CONNECT
Level_Check
Analog Input Filtering
F_ADC = ~10kHz F_PWM = ~500Hz Measure Desired Frequency C Filt R Filt Filter Freq VDock 5kHz 0.1uF 330 4.8kHz IDock In 5kHz 0.1uF 330 4.8kHz IDock Out, Low 250 0.1uF 5.6k 284Hz IDock Out, High 250 0.1uF 5.6k 284Hz IHoop Out, Low 250 0.1uF 5.6k 284Hz
Current Sensors
THIS IS WRONG

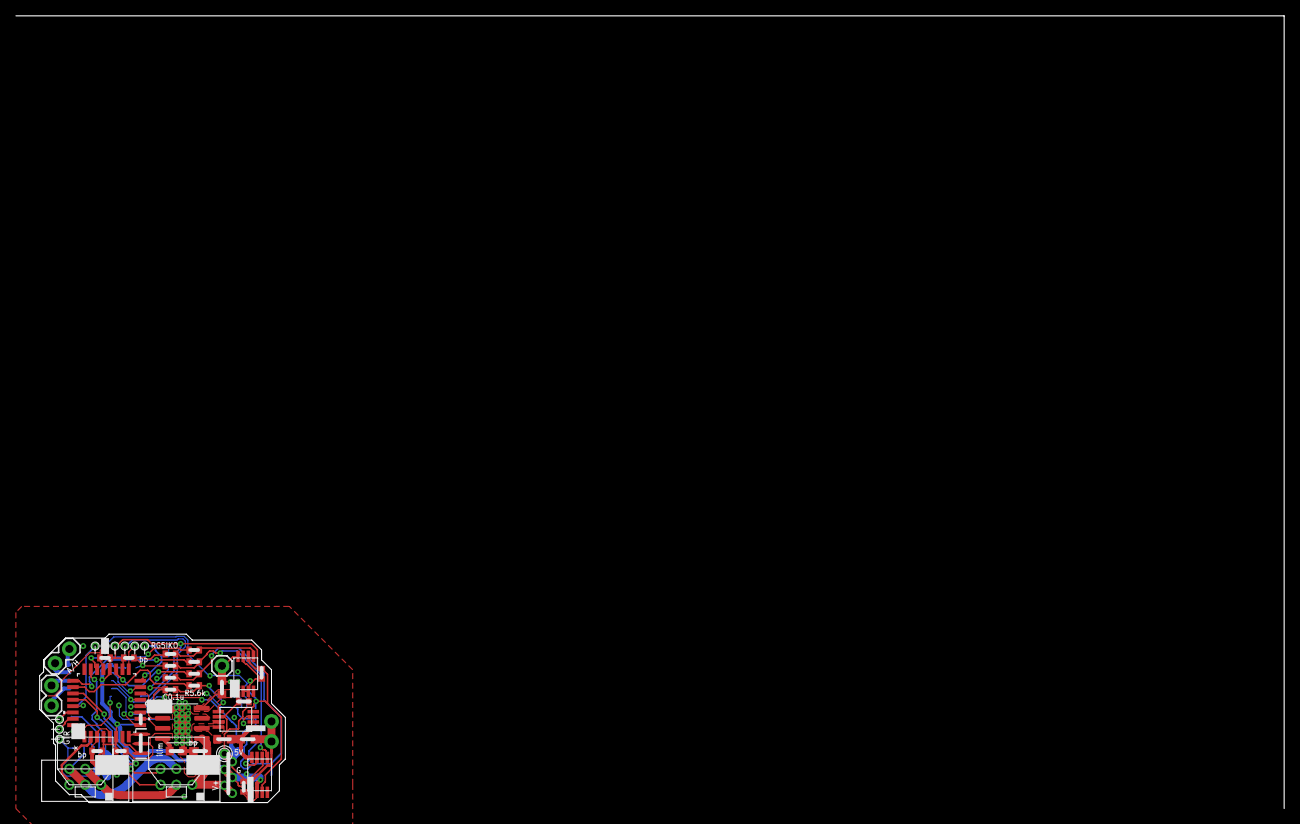
[picture p41: board fa3d_Dock_NEW_Small.brd from above]

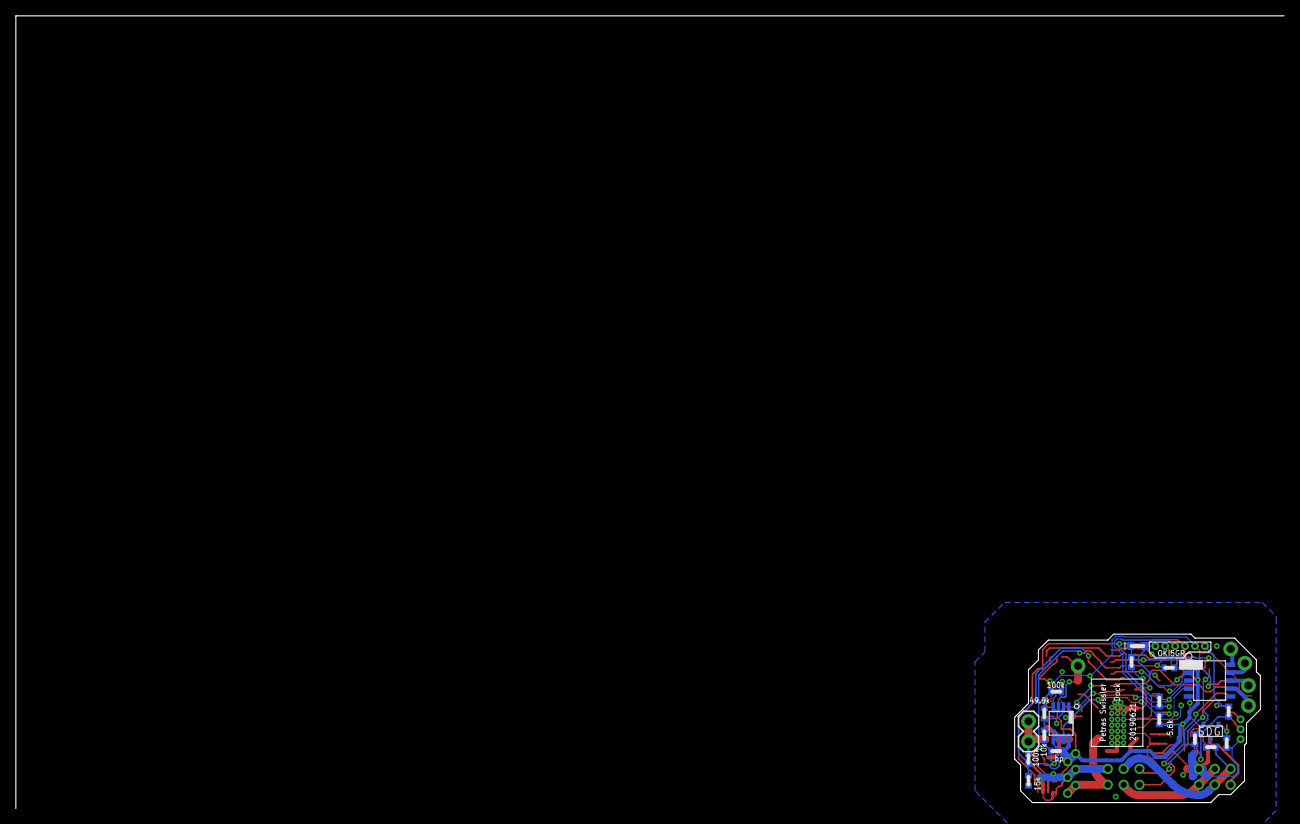
[picture p42: board fa3d_Dock_NEW_Small.brd from below]

Board: 2 copper layers, 31.0 x 21.2 mm, 60 parts (19 on the bottom side), 46 nets.
