pswiss/Swissler-2020-FireAnt3D-Design/Electronics/centerbody_logic.brd

## EAGLE design Electronics/centerbody_logic.brd (2020-07-23)

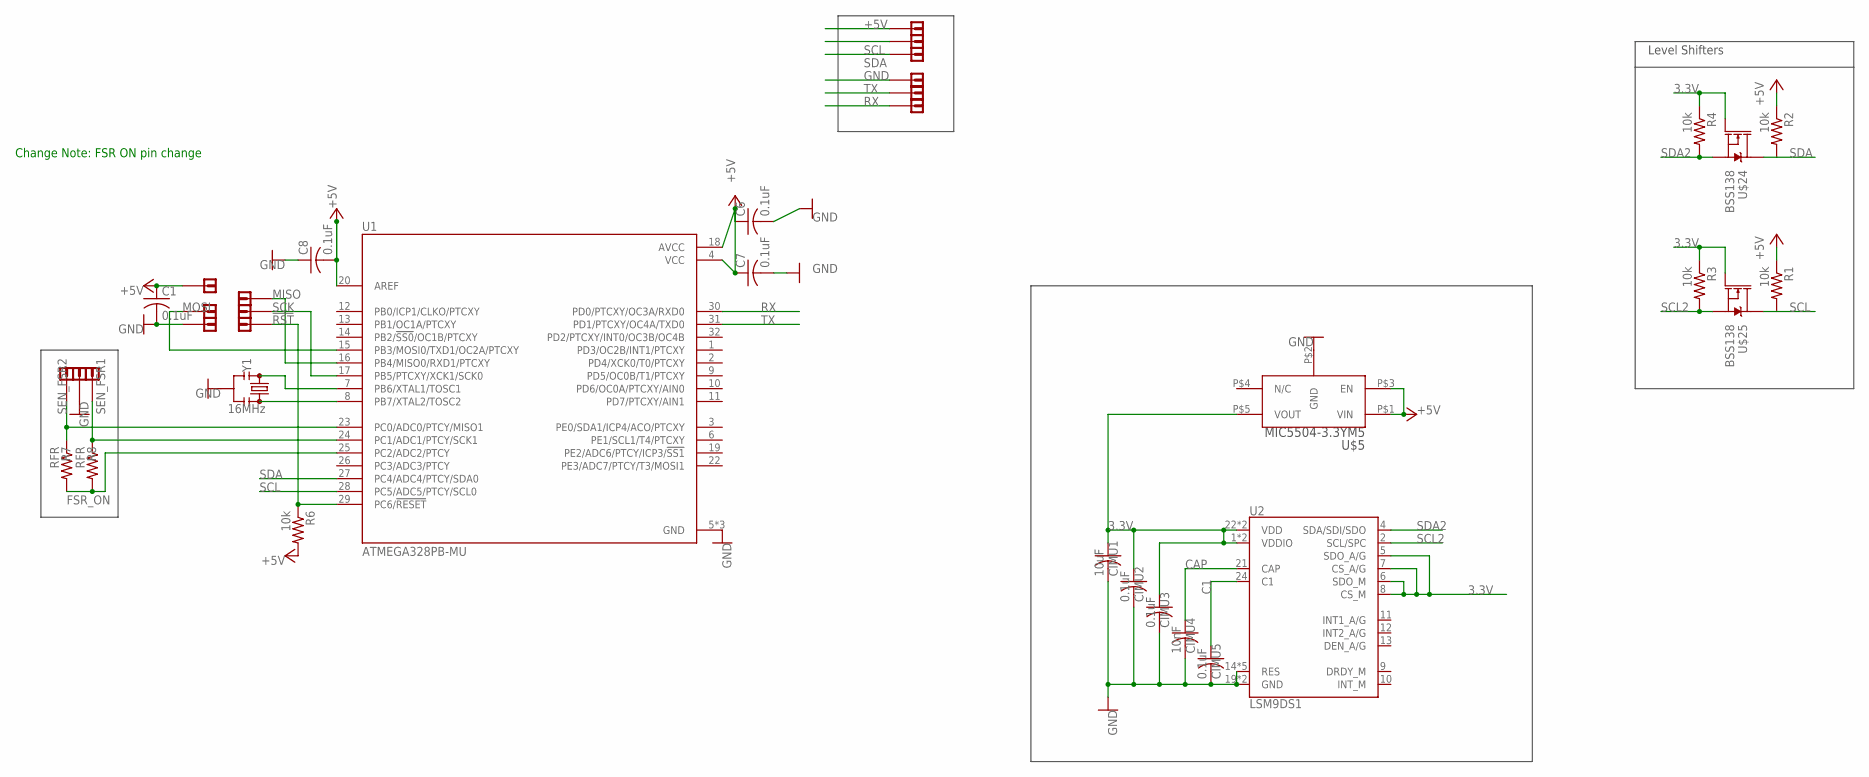
[picture p43: schematic centerbody_logic.sch]

Parts:
C1, C6, C7, C8: 0.1uF; C0402; PARTNO 885012105010
CIMU1: 10uF; C0402; PARTNO GRM155R60G106ME44D
CIMU2, CIMU3, CIMU5: 0.1uF; C0402; PARTNO 885012105010
CIMU4: 10nF; C0402; PARTNO CL05B103KB5NNNC
R1, R2, R3, R4, R6: 10k; R0402; PARTNO RR0510P-103-D
R7, R8: RFR; R0402; PARTNO CRGCQ0402F5K6
U1: ATMEGA328PB-MU; QFN50P500X500X90-33N; PARTNO ATMEGA328PB-MUR
U2: LSM9DS1; LGA24-8X4; PARTNO LSM9DS1TR
U$1, U$3, U$4, U$6, U$7, U$8, U$9, U$10, U$11, U$12, U$13, U$14, U$15, U$26, U$27: SIMPLE_VIA_CONNECTION; SIMPLEVIA
U$5: MIC5504-3.3YM5; SOT23; PARTNO MIC5504-3.3YM5-TR
U$24, U$25: BSS138; SOT-23; PARTNO BSS138
Y1: 16MHz; RESONATOR-SMD-3.2X1.3; PARTNO CSTNE16M0V530000R0

Connections:
3.3V: CIMU1.1, CIMU2.1, CIMU3.1, R3.1, R4.1, U2.1 (VDDIO), U2.3 (VDDIO), U2.5 (SDO_A/G), U2.6 (SDO_M), U2.7 (CS_A/G), U2.8 (CS_M), U2.22 (VDD), U2.23 (VDD), U$5.P$5 (VOUT), U$24.P$1 (G), U$25.P$1 (G)
!RST: R6.1, U1.29 (PC6/!RESET!), U$13.P$1
+5V: C1.1, C6.1, C7.1, C8.2, R1.1, R2.1, R6.2, U1.4 (VCC), U1.18 (AVCC), U1.20 (AREF), U$5.P$1 (VIN), U$5.P$3 (EN), U$7.P$1, U$10.P$1
C1: CIMU5.1, U2.24 (C1)
CAP: CIMU4.1, U2.21 (CAP)
FSR_ON: R7.2, R8.2, U1.25 (PC2/ADC2/PTCY)
GND: C1.2, C6.2, C7.2, C8.1, CIMU1.2, CIMU2.2, CIMU3.2, CIMU4.2, CIMU5.2, U1.5 (GND), U1.21 (GND), U1.33 (GND), U2.14 (RES), U2.15 (RES), U2.16 (RES), U2.17 (RES), U2.18 (RES), U2.19 (GND), U2.20 (GND), U$3.P$1, U$5.P$2 (GND), U$6.P$1, U$12.P$1, Y1.2
MISO: U1.16 (PB4/MISO0/RXD1/PTCXY), U$15.P$1
MOSI: U1.15 (PB3/MOSI0/TXD1/OC2A/PTCXY), U$11.P$1
unnamed: U1.8 (PB7/XTAL2/TOSC2), Y1.3
unnamed: U1.7 (PB6/XTAL1/TOSC1), Y1.1
RX: U1.30 (PD0/PTCXY/OC3A/RXD0), U$27.P$1
SCK: U1.17 (PB5/PTCXY/XCK1/SCK0), U$14.P$1
SCL: R1.2, U1.28 (PC5/ADC5/PTCY/SCL0), U$9.P$1, U$25.P$3 (D)
SCL2: R3.2, U2.2 (SCL/SPC), U$25.P$2 (S)
SDA: R2.2, U1.27 (PC4/ADC4/PTCY/SDA0), U$4.P$1, U$24.P$3 (D)
SDA2: R4.2, U2.4 (SDA/SDI/SDO), U$24.P$2 (S)
SEN_FSR1: R8.1, U1.24 (PC1/ADC1/PTCY/SCK1), U$8.P$1
SEN_FSR2: R7.1, U1.23 (PC0/ADC0/PTCY/MISO1), U$1.P$1
TX: U1.31 (PD1/PTCXY/OC4A/TXD0), U$26.P$1

Notes on the sheet:
Level Shifters
Change Note: FSR ON pin change

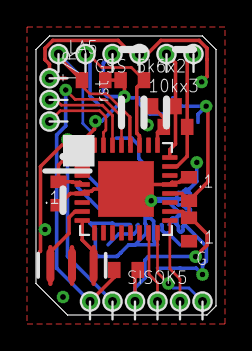
[picture p44: board centerbody_logic.brd from above]

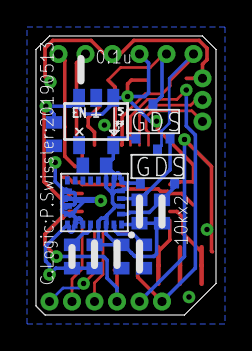
[picture p45: board centerbody_logic.brd from below]

Board: 2 copper layers, 10.0 x 15.5 mm, 37 parts (12 on the bottom side), 20 nets.
