pswiss/Swissler-2020-FireAnt3D-Design/Electronics/ProgAdapter.brd

## EAGLE design Electronics/ProgAdapter.brd (2020-07-23)

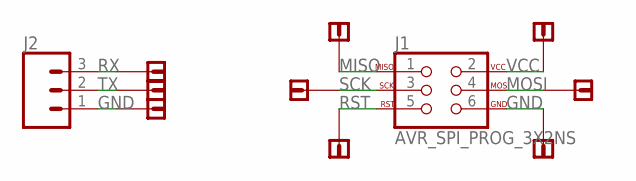
[picture p46: schematic ProgAdapter.sch]

Parts:
J1: AVR_SPI_PROG_3X2NS; 2X3-NS
J2: CONN_03; 1X03
U$1, U$2, U$3, U$4, U$5, U$6, U$7, U$8, U$9: SIMPLE_VIA_CONNECTION; SIMPLEVIA

Connections:
GND: J1.6, J2.1, U$4.P$1, U$9.P$1
MISO: J1.1, U$1.P$1
MOSI: J1.4, U$5.P$1
RST: J1.5, U$3.P$1
RX: J2.3, U$7.P$1
SCK: J1.3, U$2.P$1
TX: J2.2, U$8.P$1
VCC: J1.2, U$6.P$1

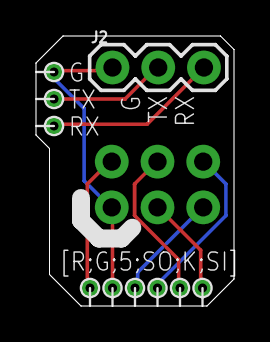
[picture p47: board ProgAdapter.brd from above]

Board: 2 copper layers, 11.0 x 15.0 mm, 11 parts (0 on the bottom side), 8 nets.
