pswiss/Swissler-2020-FireAnt3D-Design/Electronics/centerbody_Combine.brd

## EAGLE design Electronics/centerbody_Combine.brd (2020-07-23)

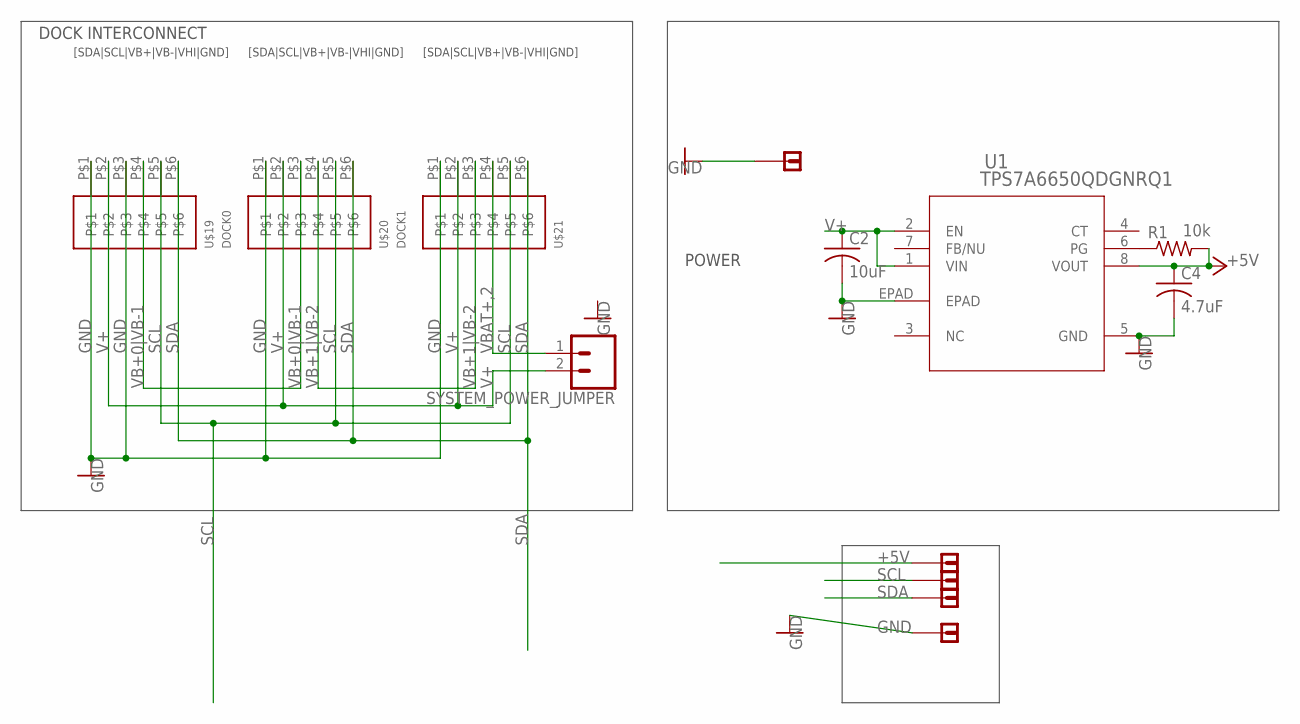
[picture p48: schematic centerbody_Combine.sch]

Parts:
C2: 10uF; C1206
C4: 4.7uF; C0402
R1: 10k; R0402
SYSTEM_POWER_JUMPER: CONN_02; 1X02
U1: TPS7A6650QDGNRQ1; DGN8_1P57X1P89
U$1, U$3, U$4, U$7, U$9: SIMPLE_VIA_CONNECTION; SIMPLEVIA
U$19: DOCK0; COMPACT_6CONN_STRAIGHT
U$20: DOCK1; COMPACT_6CONN_STRAIGHT
U$21: DOCK_2; COMPACT_6CONN_STRAIGHT

Connections:
+5V: C4.1, R1.2, U1.8 (VOUT), U$7.P$1
GND: C2.2, C4.2, U1.5 (GND), U1.EPAD, U$1.P$1, U$3.P$1, U$19.P$1, U$19.P$3, U$20.P$1, U$21.P$1
unnamed: R1.1, U1.6 (PG)
SCL: U$9.P$1, U$19.P$5, U$20.P$5, U$21.P$5
SDA: U$4.P$1, U$19.P$6, U$20.P$6, U$21.P$6
V+: C2.1, SYSTEM_POWER_JUMPER.2, U1.1 (VIN), U1.2 (EN), U$19.P$2, U$20.P$2, U$21.P$2
VB+0|VB-1: U$19.P$4, U$20.P$3
VB+1|VB-2: U$20.P$4, U$21.P$3
VBAT+,2: SYSTEM_POWER_JUMPER.1, U$21.P$4

Notes on the sheet:
[SDA|SCL|VB+|VB-|VHI|GND]
DOCK INTERCONNECT
POWER

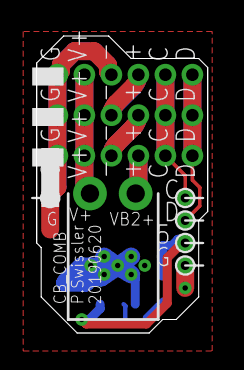
[picture p49: board centerbody_Combine.brd from above]

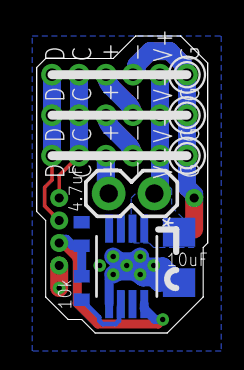
[picture p50: board centerbody_Combine.brd from below]

Board: 2 copper layers, 9.5 x 16.5 mm, 13 parts (8 on the bottom side), 9 nets.
