pswiss/Swissler-2020-FireAnt3D-Design/Electronics/fa3d_Buck.brd

## EAGLE design Electronics/fa3d_Buck.brd (2020-07-23)

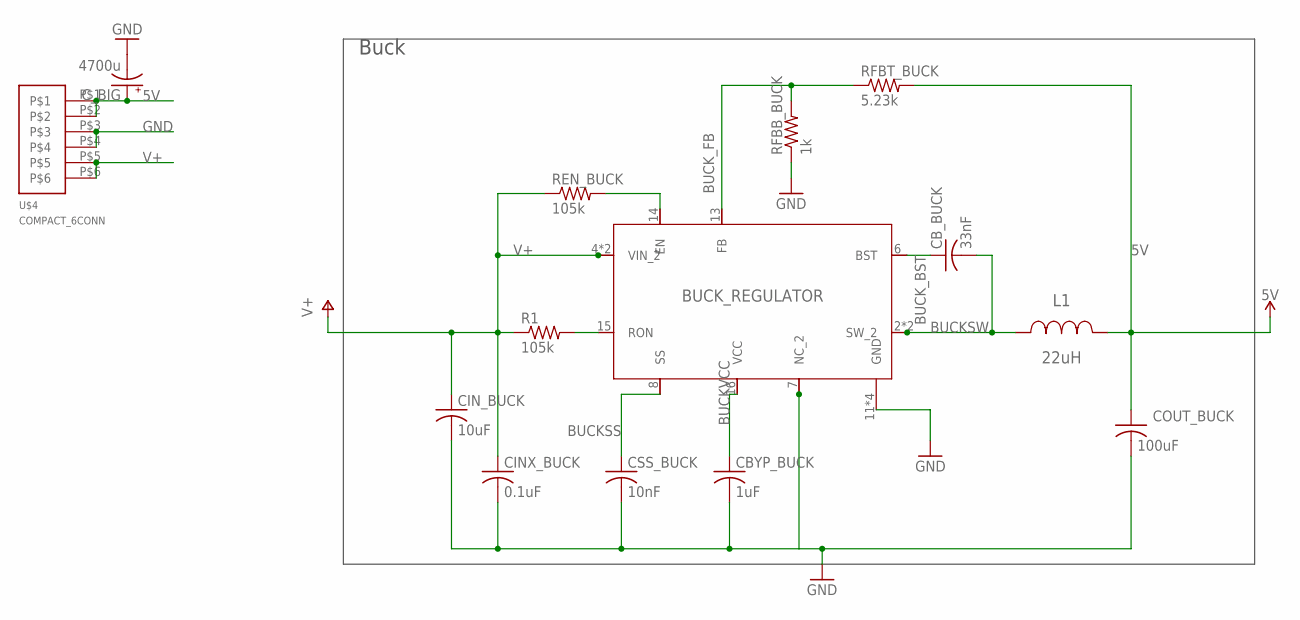
[picture p51: schematic fa3d_Buck.sch, sheet 1]

Parts:
BUCK_REGULATOR: BUCK; MXA20A; PARTNO LM3102MH/NOPB
CBYP_BUCK: 1uF; C0603; PARTNO CL10A105KB8NNNC
CB_BUCK: 33nF; C0603; PARTNO 885012206092
CINX_BUCK: 0.1uF; C0603; PARTNO CL10B104KB8NNNC
CIN_BUCK: 10uF; C1206; PARTNO GRM188R6YA106MA73D
COUT_BUCK: 100uF; C1206; PARTNO CL31A107MQHNNNE
CSS_BUCK: 10nF; C0603; PARTNO 885012206089
C_BIG: 4700u; TT5D11; PARTNO UVR0J472MHD
L1: 22uH; SDR1307; PARTNO SDR1307-220ML
R1: 105k; R0603; PARTNO RMCF0603FT105K
REN_BUCK: 105k; R0603; PARTNO RMCF0603FT105K
RFBB_BUCK: 1k; R0603; PARTNO RMCF0603JJ1K00
RFBT_BUCK: 5.23k; R0603; PARTNO RMCF0603FT5K23
U$4: COMPACT_6CONN

Connections:
5V: COUT_BUCK.1, C_BIG.+, L1.2, RFBT_BUCK.2, U$4.P$1, U$4.P$2
BUCKEN: BUCK_REGULATOR.14 (EN), REN_BUCK.2
BUCKRON: BUCK_REGULATOR.15 (RON), R1.2
BUCKSS: BUCK_REGULATOR.8 (SS), CSS_BUCK.1
BUCKSW: BUCK_REGULATOR.2 (SW_2), BUCK_REGULATOR.3 (SW_2), CB_BUCK.2, L1.1
BUCKVCC: BUCK_REGULATOR.16 (VCC), CBYP_BUCK.1
BUCK_BST: BUCK_REGULATOR.6 (BST), CB_BUCK.1
BUCK_FB: BUCK_REGULATOR.13 (FB), RFBB_BUCK.2, RFBT_BUCK.1
GND: BUCK_REGULATOR.7 (NC_2), BUCK_REGULATOR.11 (GND), BUCK_REGULATOR.17 (GND), BUCK_REGULATOR.18 (GND), BUCK_REGULATOR.21 (GND), CBYP_BUCK.2, CINX_BUCK.2, CIN_BUCK.2, COUT_BUCK.2, CSS_BUCK.2, C_BIG.-, RFBB_BUCK.1, U$4.P$3, U$4.P$4
V+: BUCK_REGULATOR.4 (VIN_2), BUCK_REGULATOR.5 (VIN_2), CINX_BUCK.1, CIN_BUCK.1, R1.1, REN_BUCK.1, U$4.P$5, U$4.P$6

Notes on the sheet:
Buck

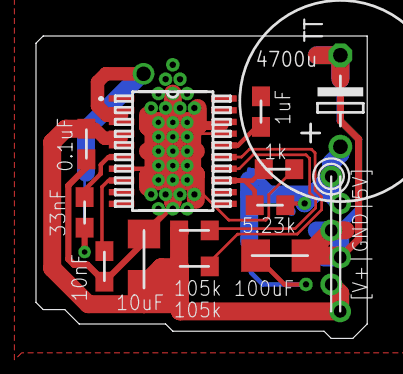
[picture p52: board fa3d_Buck.brd from above]

Board: 2 copper layers, 18.4 x 16.8 mm, 14 parts (1 on the bottom side), 10 nets.
