pswiss/Swissler-2020-FireAnt3D-Design/Code/Centerbody_code/def_pins_cb.h

/*///////////////////////////////////////////////////////////////////////
 Name:		def_pins.h
 Created:	3/30/2019
 Author:	Petras Swissler

 Purpose:	Define friendly names for all pins on the board
*////////////////////////////////////////////////////////////////////////
#pragma once
// Digital Pins ~~~~~~~~~~~~~~~~~~~~~~~~~~~~~~~~~~~~~~~~~~~~~~~~~~~~~~~~~
// Digital Outputs
// Analog pin A2
#define PIN_DO_ENABLE_FSR			A2


// Digital Inputs

// Analog Pins ~~~~~~~~~~~~~~~~~~~~~~~~~~~~~~~~~~~~~~~~~~~~~~~~~~~~~~~~~~
#define PIN_ASEN_FSR_A				0
#define PIN_ASEN_FSR_B				1

// Unused Pins ~~~~~~~~~~~~~~~~~~~~~~~~~~~~~~~~~~~~~~~~~~~~~~~~~~~~~~~~~~
// All unused pins should be defined so as to be configured as outputs
