pswiss/Swissler-2020-FireAnt3D-Design/Code/Centerbody_code/do_outputs_cb.cpp

/*//////////////////////////////////////////////////////////////////////
 Name:		do_outputs_cb
 Created:	2019-06-04
 Author:	Petras Swissler

 Purpose:	A collection of functions that send messages to the docks 
			and looks for dock feedback
*///////////////////////////////////////////////////////////////////////
#include "do_outputs_cb.h"

// High Level Functions ~~~~~~~~~~~~~~~~~~~~~~~~~~~~~~~~~~~~~~~~~~~~~~~~
// Mid Level Functions ~~~~~~~~~~~~~~~~~~~~~~~~~~~~~~~~~~~~~~~~~~~~~~~~~
// Low Level Functions ~~~~~~~~~~~~~~~~~~~~~~~~~~~~~~~~~~~~~~~~~~~~~~~~~
