pswiss/Swissler-2020-FireAnt3D-Design/Code/Centerbody_code/includes_cb.h

#pragma once
// State Phases
#include "cb_phases.h"
// Libraries 
#include "do_outputs_cb.h"
#include "def_names.h"
// Standard Libraries
#include "debug_cb.h"
#include "__manualSetup.h"
#include <stdint.h>
#include <Wire.h>

// Definitions
#include "def_friendly_names.h"
#include "def_commInterpretation.h"
#include "config_centerbody.h"

// Classes
#include "robot_centerbody.h"
//#include "SparkFunLSM6DS3.h"

// Custom Libraries
#include "outputs_cb.h"
#include "logic_cb.h"
#include "debug_cb.h"
#include "communications_cb.h"
#include "inputs_cb.h"
#include "startup_cb.h"
#include "simple_helper_functions.h"
#include "serial_helper_programs.h"
#include "vectorMathFunctions.h"
