pswiss/Swissler-2020-FireAnt3D-Design/Code/Centerbody_code/logic_cb.h

/*///////////////////////////////////////////////////////////////////////
 Name:		startup.h / .cpp
 Created:	3/30/2019
 Author:	Petras Swissler

 Purpose:
*////////////////////////////////////////////////////////////////////////
#ifndef _LOGIC_h
#define _LOGIC_h

#if defined(ARDUINO) && ARDUINO >= 100
	#include "arduino.h"
#else
	#include "WProgram.h"
#endif
/////////////////////////////////////////////////////////////////////////
// Include Libraries
#include "robot_centerbody.h"
// Low-Level Functions
// High-Level Functions
void logic(robot_centerbody*, uint8_t*);
/////////////////////////////////////////////////////////////////////////
#endif
