pswiss/Swissler-2020-FireAnt3D-Design/Code/Dock_code/def_decode_comm.h

#pragma once

#define ENC_TIME			100
#define MAX_VALUE_PWM		255
#define ENC_CURRENT_LOW		10000
#define ENC_CURRENT			100
#define ENC_VOLTAGE			7
#define ENC_INTCUR			6


#define ENC_MLT_CUR			90
#define ENC_INT_CUR			8
#define ENC_MLT_VLT_STRT	8
#define ENC_MLT_VLT_GRW_PER	100
#define ENC_MLT_VLT_END		6
#define ENC_SWP_CUR			6000
#define ENC_SWP_VLT			10
#define ENC_SWP_MOT_PWR		255
#define ENC_SWP_MOT_PWR_GRW	50
