pswiss/Swissler-2020-FireAnt3D-Design/Code/Dock_code/def_status_messages.h

/*////////////////////////////////////////////////////
 Name:		def_status_messages.h
 Created:	4/01/2019
 Author:	Petras Swissler

 Purpose:	Dictionary of messages
*/////////////////////////////////////////////////////
#pragma once

// Attach Statuses
#define STATUS_ATTACH_INIT	0x10
#define STATUS_ATTACH_SWEEP	0x11
#define STATUS_ATTACH_SWEEP_POWER_INCREASE 0x12

#define STATUS_ATTACH_MELT	0x14
#define STATUS_ATTACH_MELT_BELOW_HOOP_MOVE_THRESHOLD 0x15
#define STATUS_ATTACH_MELT_INCREASE_DOCK_VOLTAGE 0x16

#define STATUS_ATTACH_COOL	0x18

// Detach Statuses

// Flip Statuses

// Return Statuses

// Stop Statuses

// Puppet Statuses
